f4deb/JK330/Document Technique JK330.odt

TRANSCEIVER

AM – FM – SSB – CW

3 Mhz – 30 Mhz

JK330

Jérôme Jézéquel 2013

Présentation Générale

# SYSTEME TECHNIQUE

## Mise en situation

De nos jours, il existe un nombre de moyens de communication immense. La radio-communication est un système de communication très performant, même avec de petits moyen. En effet, elle permet de contacter l'autre bout de la terre facilement si les conditions atmosphériques le permettent. Elle permet de communiquer à très longue distance à de nombreux radioamateurs de par la grande plage de fréquence et des différents systèmes de modulations utilisés.

OPERATEUR 1

TERRE

OPERATEUR 2

Il s'agit d'un récepteur Superhétérodyne de première conception. Celui-ci possédera de faible caractéristiques, mais il sera conçu de manière modulaire afin de pouvoir en améliorer les différentes caractéristiques. Il devra pouvoir couvrir une plage de fréquence variant de 3 Mhz à 30 Mhz et devra aussi pouvoir démoduler les modes AM FM BLU et CW.

## Présentation du système technique

### Choix d'un récepteur superhétérodyne

Le schéma synoptique d'un récepteur traditionnel avec un seul changement de fréquence est représenté ci-dessous.

BF

Fin

Fol

Ce schéma est simplifié, mais il permettra de démontrer les limitations d'une telle structure.

On cherche à recevoir une fréquence Fin. Après amplification et filtrage, ce signal est transmit au mélangeur qui reçoit aussi le signal provenant de l'oscillateur local Fol, Si on est en présence d'un mélangeur parfait, dans le sens radiocommunication, celui-ci délivre deux produits |Fol+Fin| et |Fol-Fin|. La génération de ces deux composants est due à des éléments fortement non linéaires : diodes ou transistors. Un mélangeur parfait serai un sous ensemble parfait d'ordre 2. En pratique, la non linéarité d'ordre 2 est prépondérante mais les non linéarités d'ordre 3,4,5, etc sont aussi présentent dans des proportions plus ou moins prononcées selon le type du mélangeur. Ceci signifie donc que l'on récupère en sortie plusieurs raies ou fréquences |mFol +- nFin| avec m et n entiers. Si m=1 et n=1, il s'agit du cas parfait mais toutes les combinaisons sont possibles.

Maintenant, traitons le choix de la fréquence intermédiaire FI, L'intérêt de cette fréquence est de faciliter le traitement de Fin.

Pour ce faire une idée, imaginons que Fin=10 Mhz et Fol=11 Mhz, il en résulte une fréquence FI=1Mhz et une deuxième FI=21Mhz qui est à éliminer. Celle-ci est éloignée de FI=20 Mhz et donc plus facile à supprimer. Notons que les produits d'intermodulations sont respectivement 12 Mhz, 31 Mhz et 32 Mhz tout aussi facile à supprimer.

Première constatation et conclusion, plus FI est faible et plus il est facile de l'amplifier et de le filtrer.

Maintenant, Fin = 12 Mhz et Fol = 11Mhz. Il en résulte une FI à 1 Mhz et une à 23 Mhz. Donc lorsque l’oscillateur locale est calé sur une fréquence, il reçoit deux fréquences simultanément. La fréquence à 23 Mhz est dite fréquence image. Elle est espacée de la fréquence à recevoir de 2xFol. Il faudra donc prendre une FI très grande, ce qui est contraire à la première conclusion.

Pour cette valeur, il n'y a pas de solution miracle, tout dépend de l’application. Le plus souvent, on rencontre les fréquences suivantes : 455Khz, 10,7Mhz, 21,4Mhz, 45Mhz, 70Mhz, 38,9Mhz en TV et 480Mhz en TVSat,

Reprenons le premier exemple, et supposons que l’on souhaite couvrir la plage de fréquence allant de 11Mhz à 12Mhz et que les Fi se situe entre 12 et 13 Mhz. Le filtre d'entrée doit éliminer les fréquences images. Il est clair que plus la FI est élevée et plus le filtre d'entrée est aisé à faire. De plus, plus la FI est basse et plus le coefficient de surtension du filtre devra être important et donc le filtre sera plus difficile à concevoir. Donc si on veut couvrir une large bande, il faudra que le filtre d'entrée soit asservit à l'oscillateur local ceci afin d'éliminer la fréquence image.

Une des premières possibilités serai de tronçonner la bande des fréquence à recevoir en plusieurs sous bandes; mais ceci nous contraindrai à faire autant d’oscillateur local que de sous bande.

Finalement une FI haute apporte une solution assez simple.

On en a conclut que le schéma synoptique précédant ne convient pas pour l'application prévu dans ce récepteur. La principale cause étant la difficulté de réaliser l'oscillateur local.

Si on prend le problème à l'envers, on s’aperçoit que l'on sait faire des oscillateurs allant de F à 2F, soit une octave. On sait aussi que la plage de couverture de l'oscillateur local est identique à celle de la plage de couverture du signal d'entré.

FI = Fol min – Fin min = Fol max -Fin max

FI < Fin min ou FI> Fin max

Donc pour couvrir la plage de 3Mhz à 30Mhz, il faut que Fol min = 45 Mhz+3 Mhz soit 48 Mhz et FI > 45 Mhz

Donc Fol min = 48 Mhz, Fol max = 75 Mhz pour FI = 45 Mhz. De plus Fimage = 90 Mhz,

Comme Fimage >> FI, celle ci sera plus facile à supprimer et donc le filtrage sera plus facile,

On effectuera un deuxième changement de fréquence à 9Mhz.

## Analyse Fonctionnelle du système

### Fonction d'usage

La fonction du système est de permettre l'écoute et la transmission de signaux entre radioamateurs entre 3 Mhz et 30 Mhz parmi les modes de transmissions tel que FM AM SSB et CW,

### Schéma fonctionnel de niveau 1 :

Opérateur

Antenne

Traitement

### Schéma fonctionnel de niveau 2 :

Traitement

Ondes accoustiques / Signal éléctrique

Ondes éléctromagnetique

ANALOGIQUE

Prise en compte des paramètres

NUMERIQUE

Réglages des paramètres en façade

Visualisation de la fréquence et des différents paramètres

JK330

## Analyse fonctionnelle :

### Présentation de la façade

C'est à partir de la façade que tous les réglages seront effectués. Les fonctions suivantes seront accessibles directement en façade.

Afficheur Monochrome LCD 240*64

Voyants :

- A : TX/RX
- B : PLL
- C : Alim ext
- D : Alim interne
- E : 12V
- F : 12 VTX
- G : 12 VRX
- H : 8V
- I : 5VA
- J : 5VD
- K : 3,3V

Fonctions :

- 1 : On/Off
- 2 : Volume
- 3 : AGC
- 4 : Band select 3,5/7/10/14/18/21/24/28
- 5 : VFO
- 6 : AF Gain
- 7 : RF Gain
- 8 : VFO CLAR
- 9 : Mod select LSB/USB/CW/FM
- 10 : Touche Fonction F1,, F7
- 11 : Clavier Numerique

Connexions Face Avant

- DIN 5 Broches
- Phone jack 6,5 mm
- Key Jack 3,5 mm
- DATA DB9
- RJ12 DEBUG

### Présentation de la face arrière

Les connexions suivantes seront disponibles en face arrière.

- 1 : Fiche secteur 220V
- 2 : Entrée 12V externe
- 3 : Antenne HF
- 4 : Antenne 50 Mhz
- 5 : Antenne VHF
- 6 : Antenen UHF

## Schéma fonctionnel RADIO du 1 er degrés

Ampli HF Sélection Filtre Passe bas Préampli HF HF Sélection antenne Sélection Filtre Passe Bande

Antenne

HF/50/VHF/UHF

Oscillateur 48Mhz-75Mhz 1er Mixer

Commutation HF RX / TX

Commutation HF RX / TX

Commutation HF RX / TX Ampli 45Mhz Ampli 45 Mhz Filtre à Quartz 45 Mhz 12,5Khz

Commutation HF RX / TX 2ème Mixer Commutation HF RX / TX

Oscillateur 54Mhz

Filtre à Quartz 9 Mhz 2,7Khz Ampli 9Mhz Commutation HF RX / TX

Ampli 9 Mhz Commutation HF RX / TX

Filtre BF

Ampli micro

Ampli BF

# MODULE JK330-1-BF

## Présentation

## Schéma Fonctionnel

## Schéma Structurel

## Typon

## Nomenclature

## Test et mise au point

# Module JK330-2-9Mhz

## Présentation

## Schéma Fonctionnel

## Schéma Structurel

## Typon

## Nomenclature

## Test et mise au point

# Module JK330-3-45Mhz

## Présentation

## Schéma Fonctionnel

## Schéma Structurel

## Typon

## Nomenclature

## Test et mise au point

# Module JK330-4-HF

## Présentation

## Schéma Fonctionnel

## Schéma Structurel

## Typon

## Nomenclature

## Test et mise au point

# Module JK330-5-OL9

## Présentation

## Schéma Fonctionnel

## Schéma Structurel

## Typon

## Nomenclature

## Test et mise au point

# Module JK330-6-OL54

## Présentation

## Schéma Fonctionnel

## Schéma Structurel

## Typon

## Nomenclature

## Test et mise au point

# Module JK330-7-SYNTHE

## Présentation

## Schéma Fonctionnel

## Schéma Structurel

## Typon

## Nomenclature

## Test et mise au point

# Module JK330-8-CPU

## Présentation

Le transceiver sera piloté par la carte MCU à base du PIC32MX795F512H.

Ce micro-contrôleur possède toutes les fonctions nécessaires ainsi que des fonctions qui pourront être développées par la suite.

Cette carte sera donc composée des fonctions suivantes :

- ICD pour la programmation et le developpement.
- Bouton RST pour effectuer un Reset manuel de la carte
- Connecteur KK-5 pour l'entrée des alimentations : GND/3,3V/5VA/5VD/12V
- Connecteur KK-4 pour la liaison I2C
- 2 Connecteurs KK-4 pour 2 liaisons série (une pour le débug et une pour communiquer avec l'exterieur.
- 5 Connecteurs KK-3 pour des I/O
- 3 Connecteurs HE10-10 permettant de commander chacun un clavier de 16 touches ainsi que 2 leds.
- Connecteur HE10-20 permettant de piloter un LCD graphique 240*64 monochrome
- 14 Connecteurs KK-3, soit 14 convertisseurs ou I/O.

## Schéma Fonctionnel

## Schéma Structurel

## Typon

## Nomenclature

## Test et mise au point

Avant de mettre sous tension la carte, il faut au préalable vérifier la continuité et surtout l'absence de cour-circuit entre les différentes alimentations.

TEST RS232

Pour tester la RS232-2 et RS232-3, il faut charger le projet

« TEST ELECTRONICAL_MAIN_BOARD_32.mcp » avec le fichier « testUartPic32.c »

compiler :

#define UARTTEST UART2 pour tester la RS232-2

#define UARTTEST UART3 pour tester la RS232-3

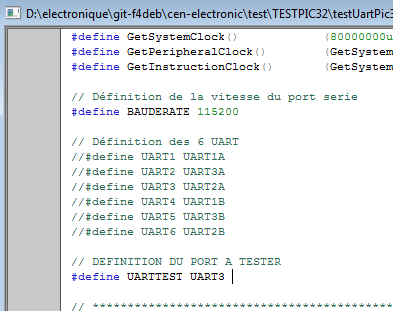
[picture p1: figure]

à l'aide de Termite, vérifier l'émission puis saisir « y » pour tester la réception du Pic32MX795F512H.

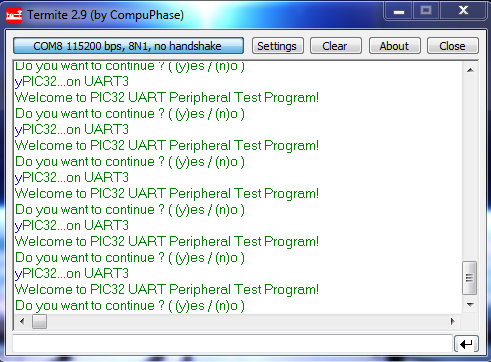
[picture p2: figure]

# Module JK330-9-POWER

## Présentation

Afin de disposer des différentes tensions d'alimentations nécessaires au fonctionnement des différentes cartes, la carte POWER fournira six différentes tensions. La tension + Batt qui est la tension fournit par l'alimentation interne 220V/13,8V. Cette partie n'a comme limite de courant que sa source. Elle est de 10A max pour l'alimentation 220V,

La tension 12V est régulée et fonctionne avec une tension d'alimentation pouvant varier de 4,75V à 25V. Son courant MAX est de 3A,

La tension 5V est régulée et fonctionne avec une tension d'alimentation pouvant varier de 4,75V à 25V. Son courant MAX est de 3A,

Les tensions +5VA et -5VA sont régulées à partir de la tension régulée de 5V, le courant est de +-300mA,

La tension 3,3V est régulée à partir de la tension +5V, le courant Max est de 800mA,

Le fonctionnement de chaque tension est visualisé avec une led verte par tension,

## Schéma Fonctionnel

+13,8V /10A +12V/3A +5V/3A +5VA/300mA -5VA/300mA +3,3V/800mA

Régulation en tension

Entrée 220V

X10 Connecteurs

6 leds

## Schéma Structurel

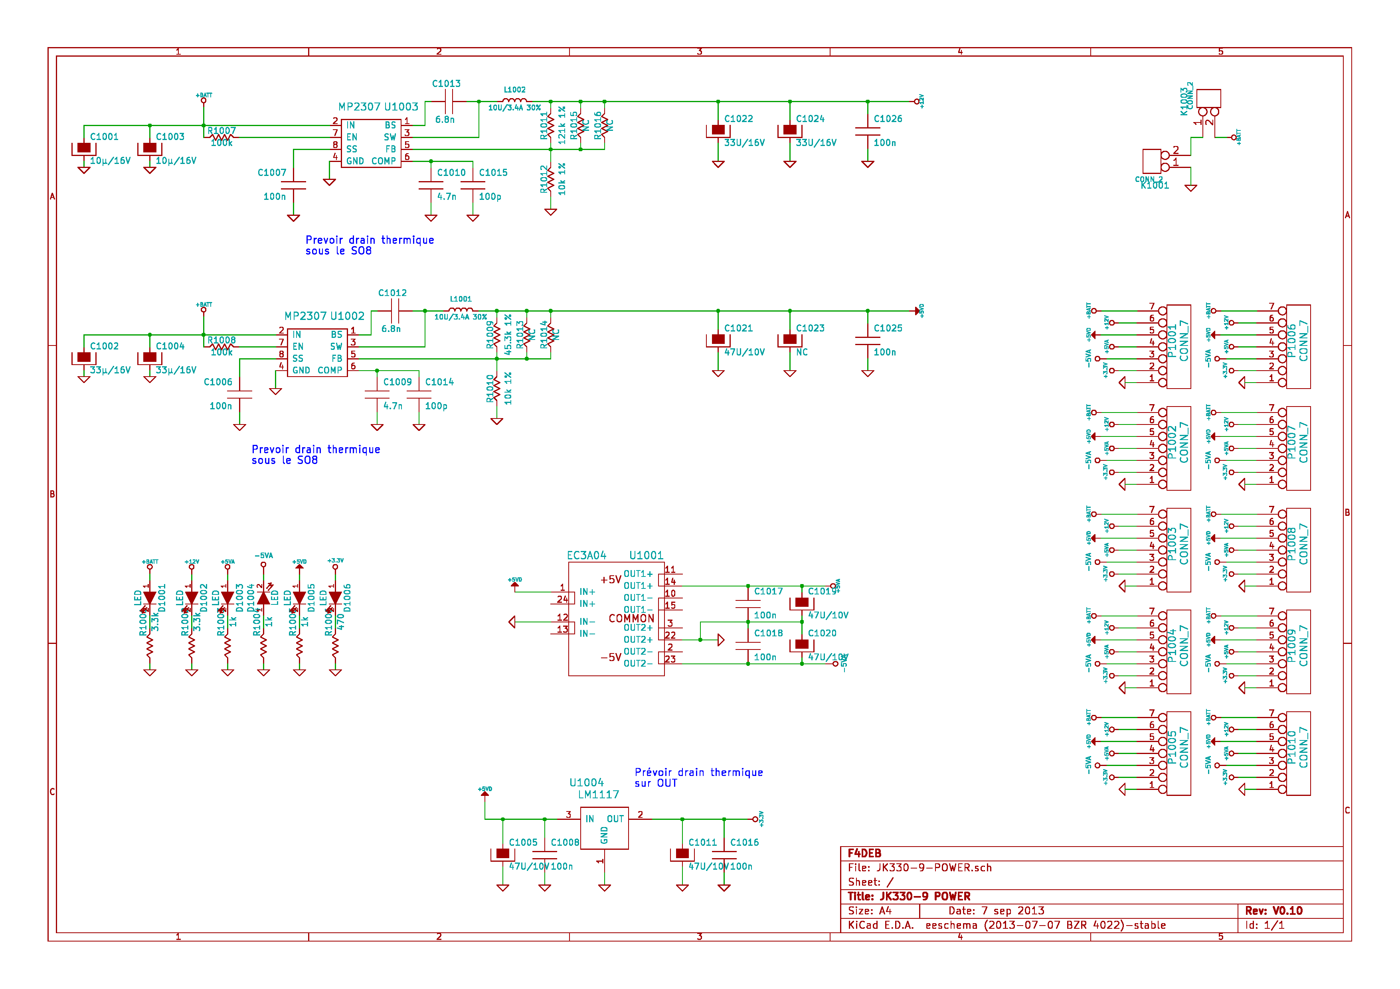
[picture p3: figure]

## Typon

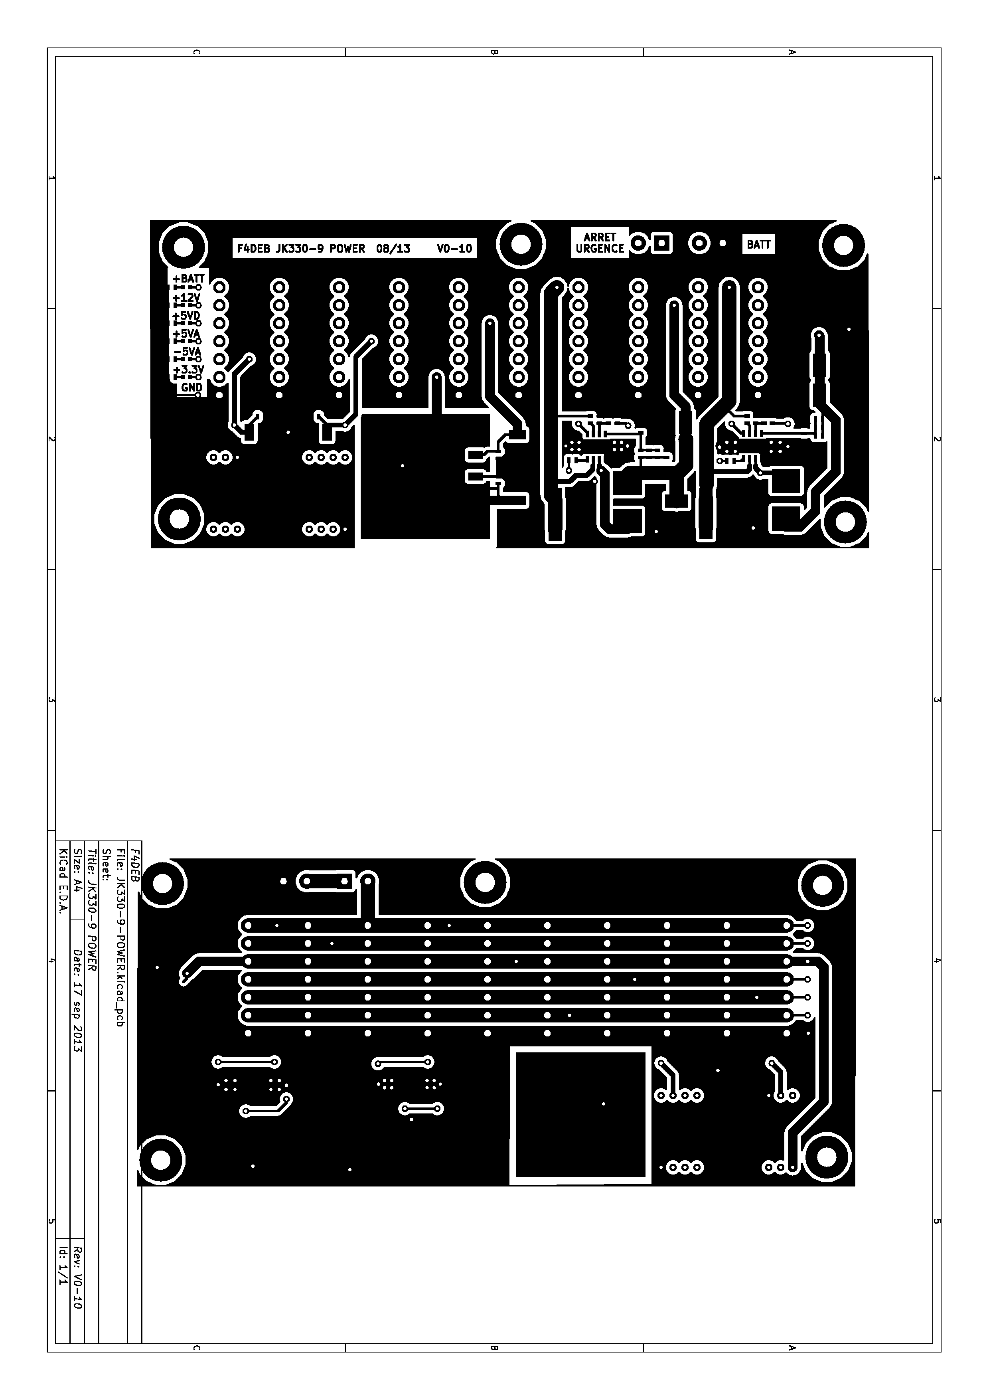
[picture p4: figure]

## Implantation

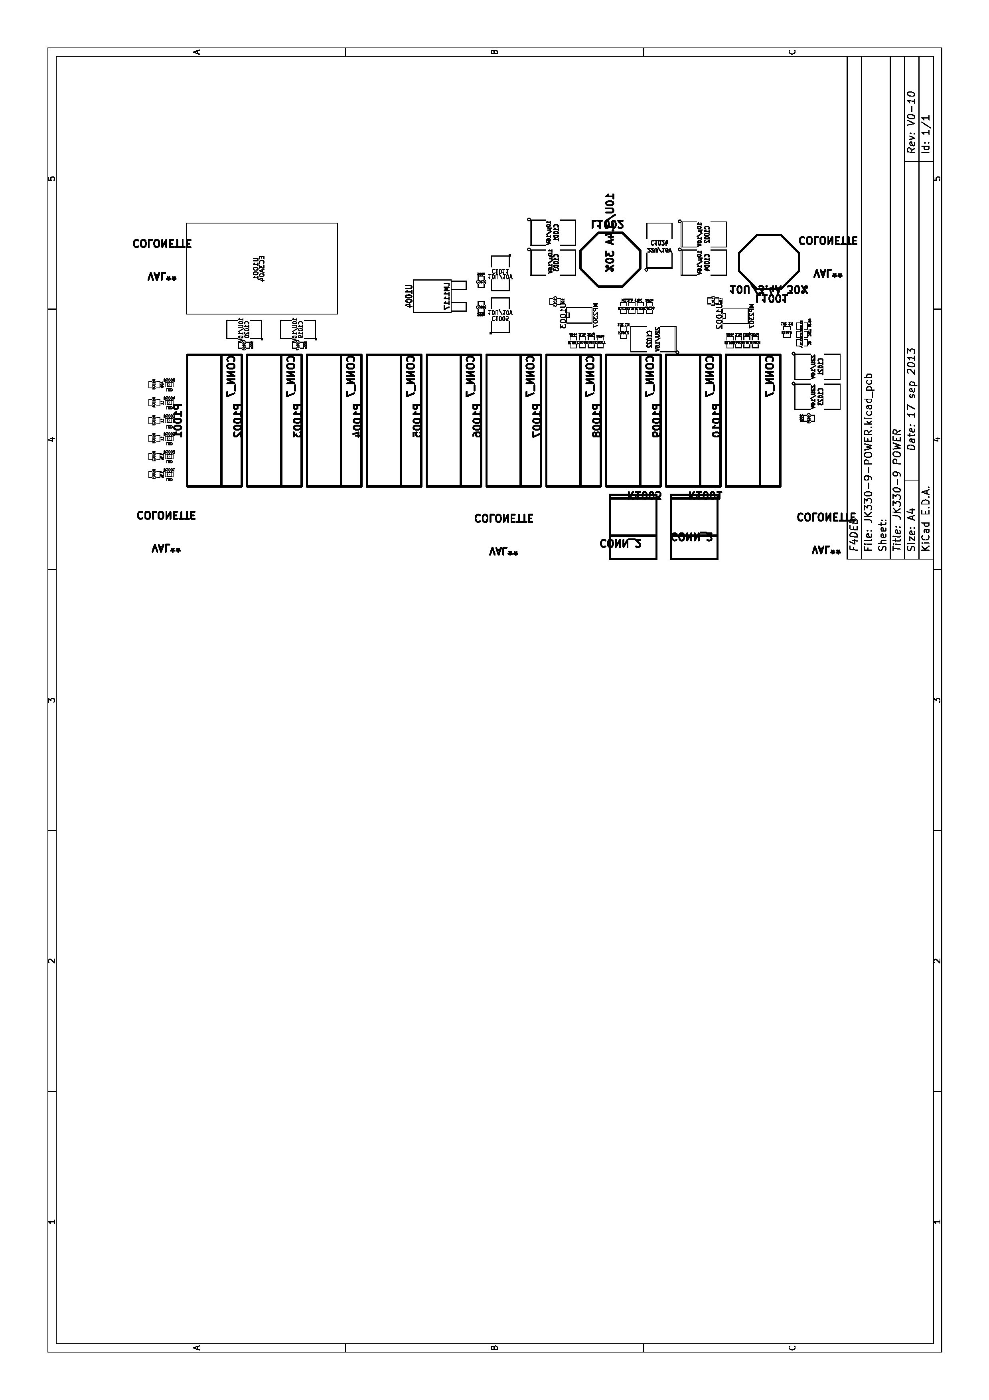
[picture p5: figure]

## Nomenclature

eeschema (2013-07-07 BZR 4022)-stable >> Creation date: 17/09/2013 22:07:12

#Cmp ( ordre = RÃ©fÃ©rence )

| C1001 10Âµ/16V ~ ; ~ ; ~

| C1002 33Âµ/16V ~ ; ~ ; ~

| C1003 10Âµ/16V ~ ; ~ ; ~

| C1004 33Âµ/16V ~ ; ~ ; ~

| C1005 47U/10V ~ ; ~ ; ~

| C1006 100n CMS 0603

| C1007 100n CMS 0603

| C1008 100n CMS 0603

| C1009 4.7n CMS 0603

| C1010 4.7n CMS 0603

| C1011 47U/10V ~ ; ~ ; ~

| C1012 6.8n CMS 0603

| C1013 6.8n CMS 0603

| C1014 100p CMS 0603

| C1015 100p CMS 0603

| C1016 100n CMS 0603

| C1017 100n CMS 0603

| C1018 100n CMS 0603

| C1019 47U/10V ~ ; ~ ; ~

| C1020 47U/10V ~ ; ~ ; ~

| C1021 47U/10V ~ ; ~ ; ~

| C1022 33U/16V ~ ; ~ ; ~

| C1023 NC ~ ; ~ ; ~

| C1024 33U/16V ~ ; ~ ; ~

| C1025 100n CMS 0603

| C1026 100n CMS 0603

| D1001 LED LED CMS 0603

| D1002 LED LED CMS 0603

| D1003 LED LED CMS 0603

| D1004 LED LED CMS 0603

| D1005 LED LED CMS 0603

| D1006 LED LED CMS 0603

| K1001 CONN_2 Phoenix Contact 5,08mm

| K1003 CONN_2 Phoenix Contact 5,08mm

| L1001 10U/3.4A 30%CMS

| L1002 10U/3.4A 30%CMS

| P1001 CONN_7 Phoenix Contact 3,5mm

| P1002 CONN_7 Phoenix Contact 3,5mm

| P1003 CONN_7 Phoenix Contact 3,5mm

| P1004 CONN_7 Phoenix Contact 3,5mm

| P1005 CONN_7 Phoenix Contact 3,5mm

| P1006 CONN_7 Phoenix Contact 3,5mm

| P1007 CONN_7 Phoenix Contact 3,5mm

| P1008 CONN_7 Phoenix Contact 3,5mm

| P1009 CONN_7 Phoenix Contact 3,5mm

| P1010 CONN_7 Phoenix Contact 3,5mm

| R1001 3.3k RES 5% 0603

| R1002 3.3k RES 5% 0603

| R1003 1k RES 5% 0603

| R1004 1k RES 5% 0603

| R1005 1k RES 5% 0603

| R1006 470 RES 5% 0603

| R1007 100k RES 5% 0603

| R1008 100k RES 5% 0603

| R1009 45.3k 1% ~ ; ~ ; ~

| R1010 10k 1% RES 1% 0603

| R1011 121k 1% ~ ; ~ ; ~

| R1012 10k 1% RES 1% 0603

| R1013 NC ~ ; ~ ; ~

| R1014 NC ~ ; ~ ; ~

| R1015 NC ~ ; ~ ; ~

| R1016 NC ~ ; ~ ; ~

| U1001 EC3A04 ; ;

| U1002 MP2307 ; ;

| U1003 MP2307 ; ;

| U1004 LM1117 ; ;

#End Cmp

#End List

## Test et mise au point

- Effectuer un test de continuité sur chaque sortie
- Effectuer un test de continuité sur l'entrée alim,
- Mettre sous tension
- Vérifier l'allumage des 6 leds de visualisation des tensions : D1001-D1006
- Vérifier la tension sur chaque sortie,
- TEST EN CHARGE DES TENSIONS
- Sur la sortie + 12V, brancher une lampe de voiture de 21W+5W+5W
- Sur la sortie +5V, brancher une lampe de voiture de
- Sur la sortie +5VA
- Sur la sortie -5VA
- Sur la sortie +3,3V

## PHOTOS
