f4deb/JK330/Ariane/ariane.png

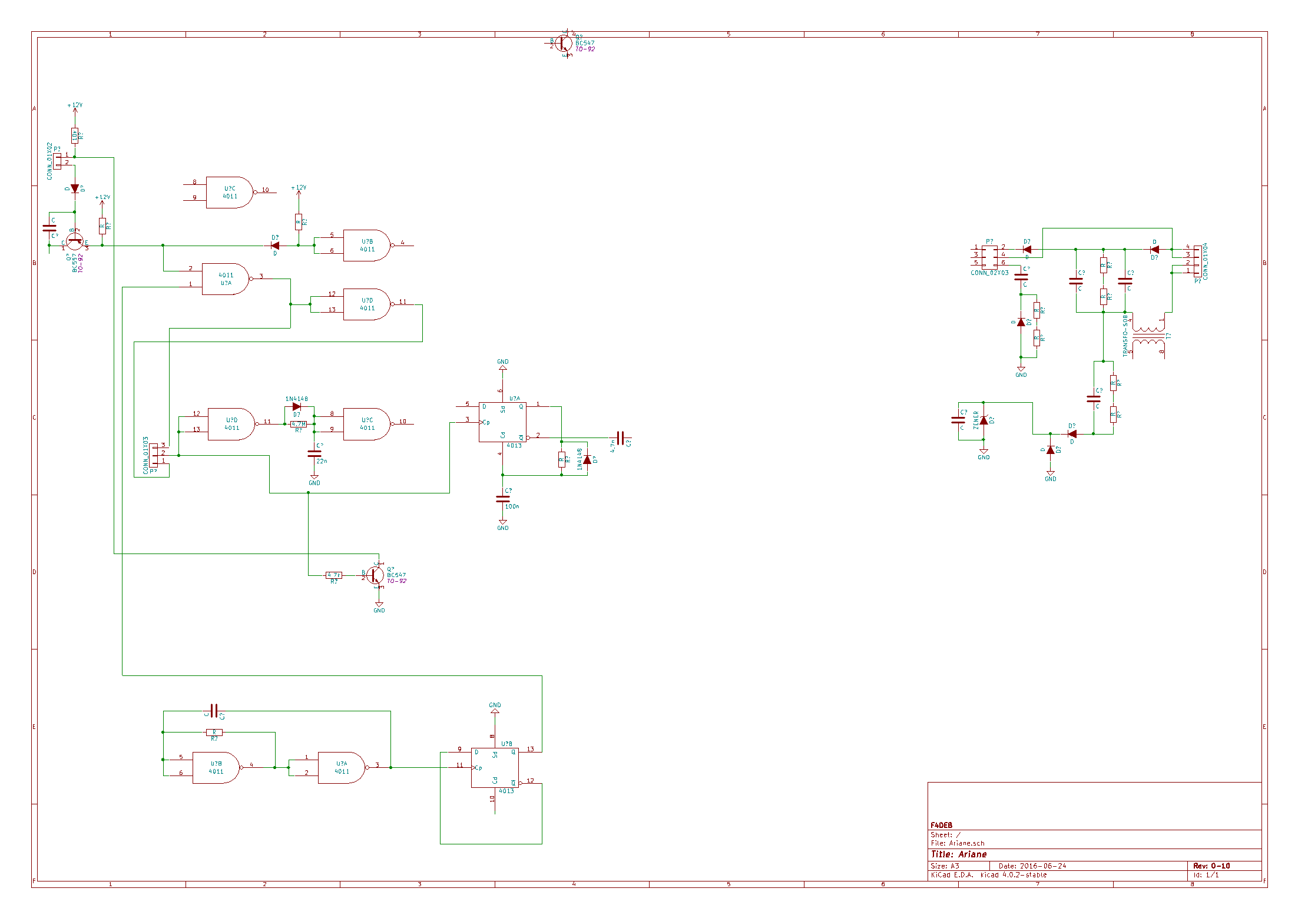
Ariane/ariane.png
