f4deb/JK330/Power_expander/V1-00/power expandleur.kicad_pcb

## KiCad design Power_expander/V1-00/power expandleur.kicad_pcb (2017-03-22, an earlier design)

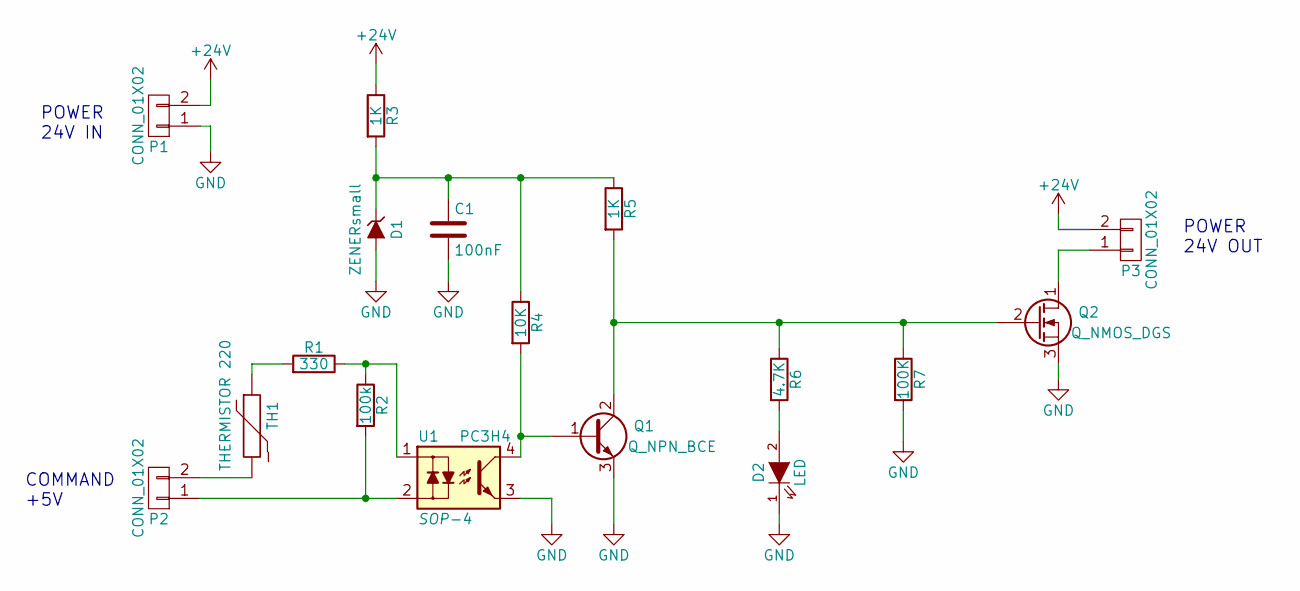
[picture p7: schematic power expandleur.sch, Power Expander]

Parts:
C1: 100nF; C_0603
D1: ZENERsmall; SMA_Standard
D2: LED; LED_0805
P1, P2, P3: CONN_01X02; bornier2
Q1: Q_NPN_BCE; SOT-23
Q2: Q_NMOS_DGS; SOT-669_LFPAK
R1: 330; R_0603
R2: 100k; R_0603
R3, R5: 1K; R_0603
R4: 10K; R_0603
R6: 4.7K; R_0603
R7: 100K; R_0603
TH1: THERMISTOR 220; R_0603
U1: PC3H4; SOP-4

Connections:
+24V: P1.2, P3.2, R3.1
GND: C1.2, D1.2 (A), D2.1 (K), P1.1, Q1.3 (E), Q2.3 (S), R7.2, U1.3
unnamed: C1.1, D1.1 (K), R3.2, R4.1, R5.1
unnamed: D2.2 (A), R6.2
unnamed: P2.1, R2.2, U1.2
unnamed: P2.2, TH1.2
unnamed: P3.1, Q2.1 (D)
unnamed: Q1.1 (B), R4.2, U1.4
unnamed: Q1.2 (C), Q2.2 (G), R5.2, R6.1, R7.1
unnamed: R1.1, R2.1, U1.1
unnamed: R1.2, TH1.1

Notes on the sheet:
POWER 24V IN
POWER 24V OUT
COMMAND +5V

Board: 2 copper layers, 16 parts (0 on the bottom side), 11 nets, no tracks yet.
