f4deb/JK330/JK330-10-INTERFACE/IHM.kicad_pcb

## KiCad design JK330-10-INTERFACE/IHM.kicad_pcb (2014-02-02)

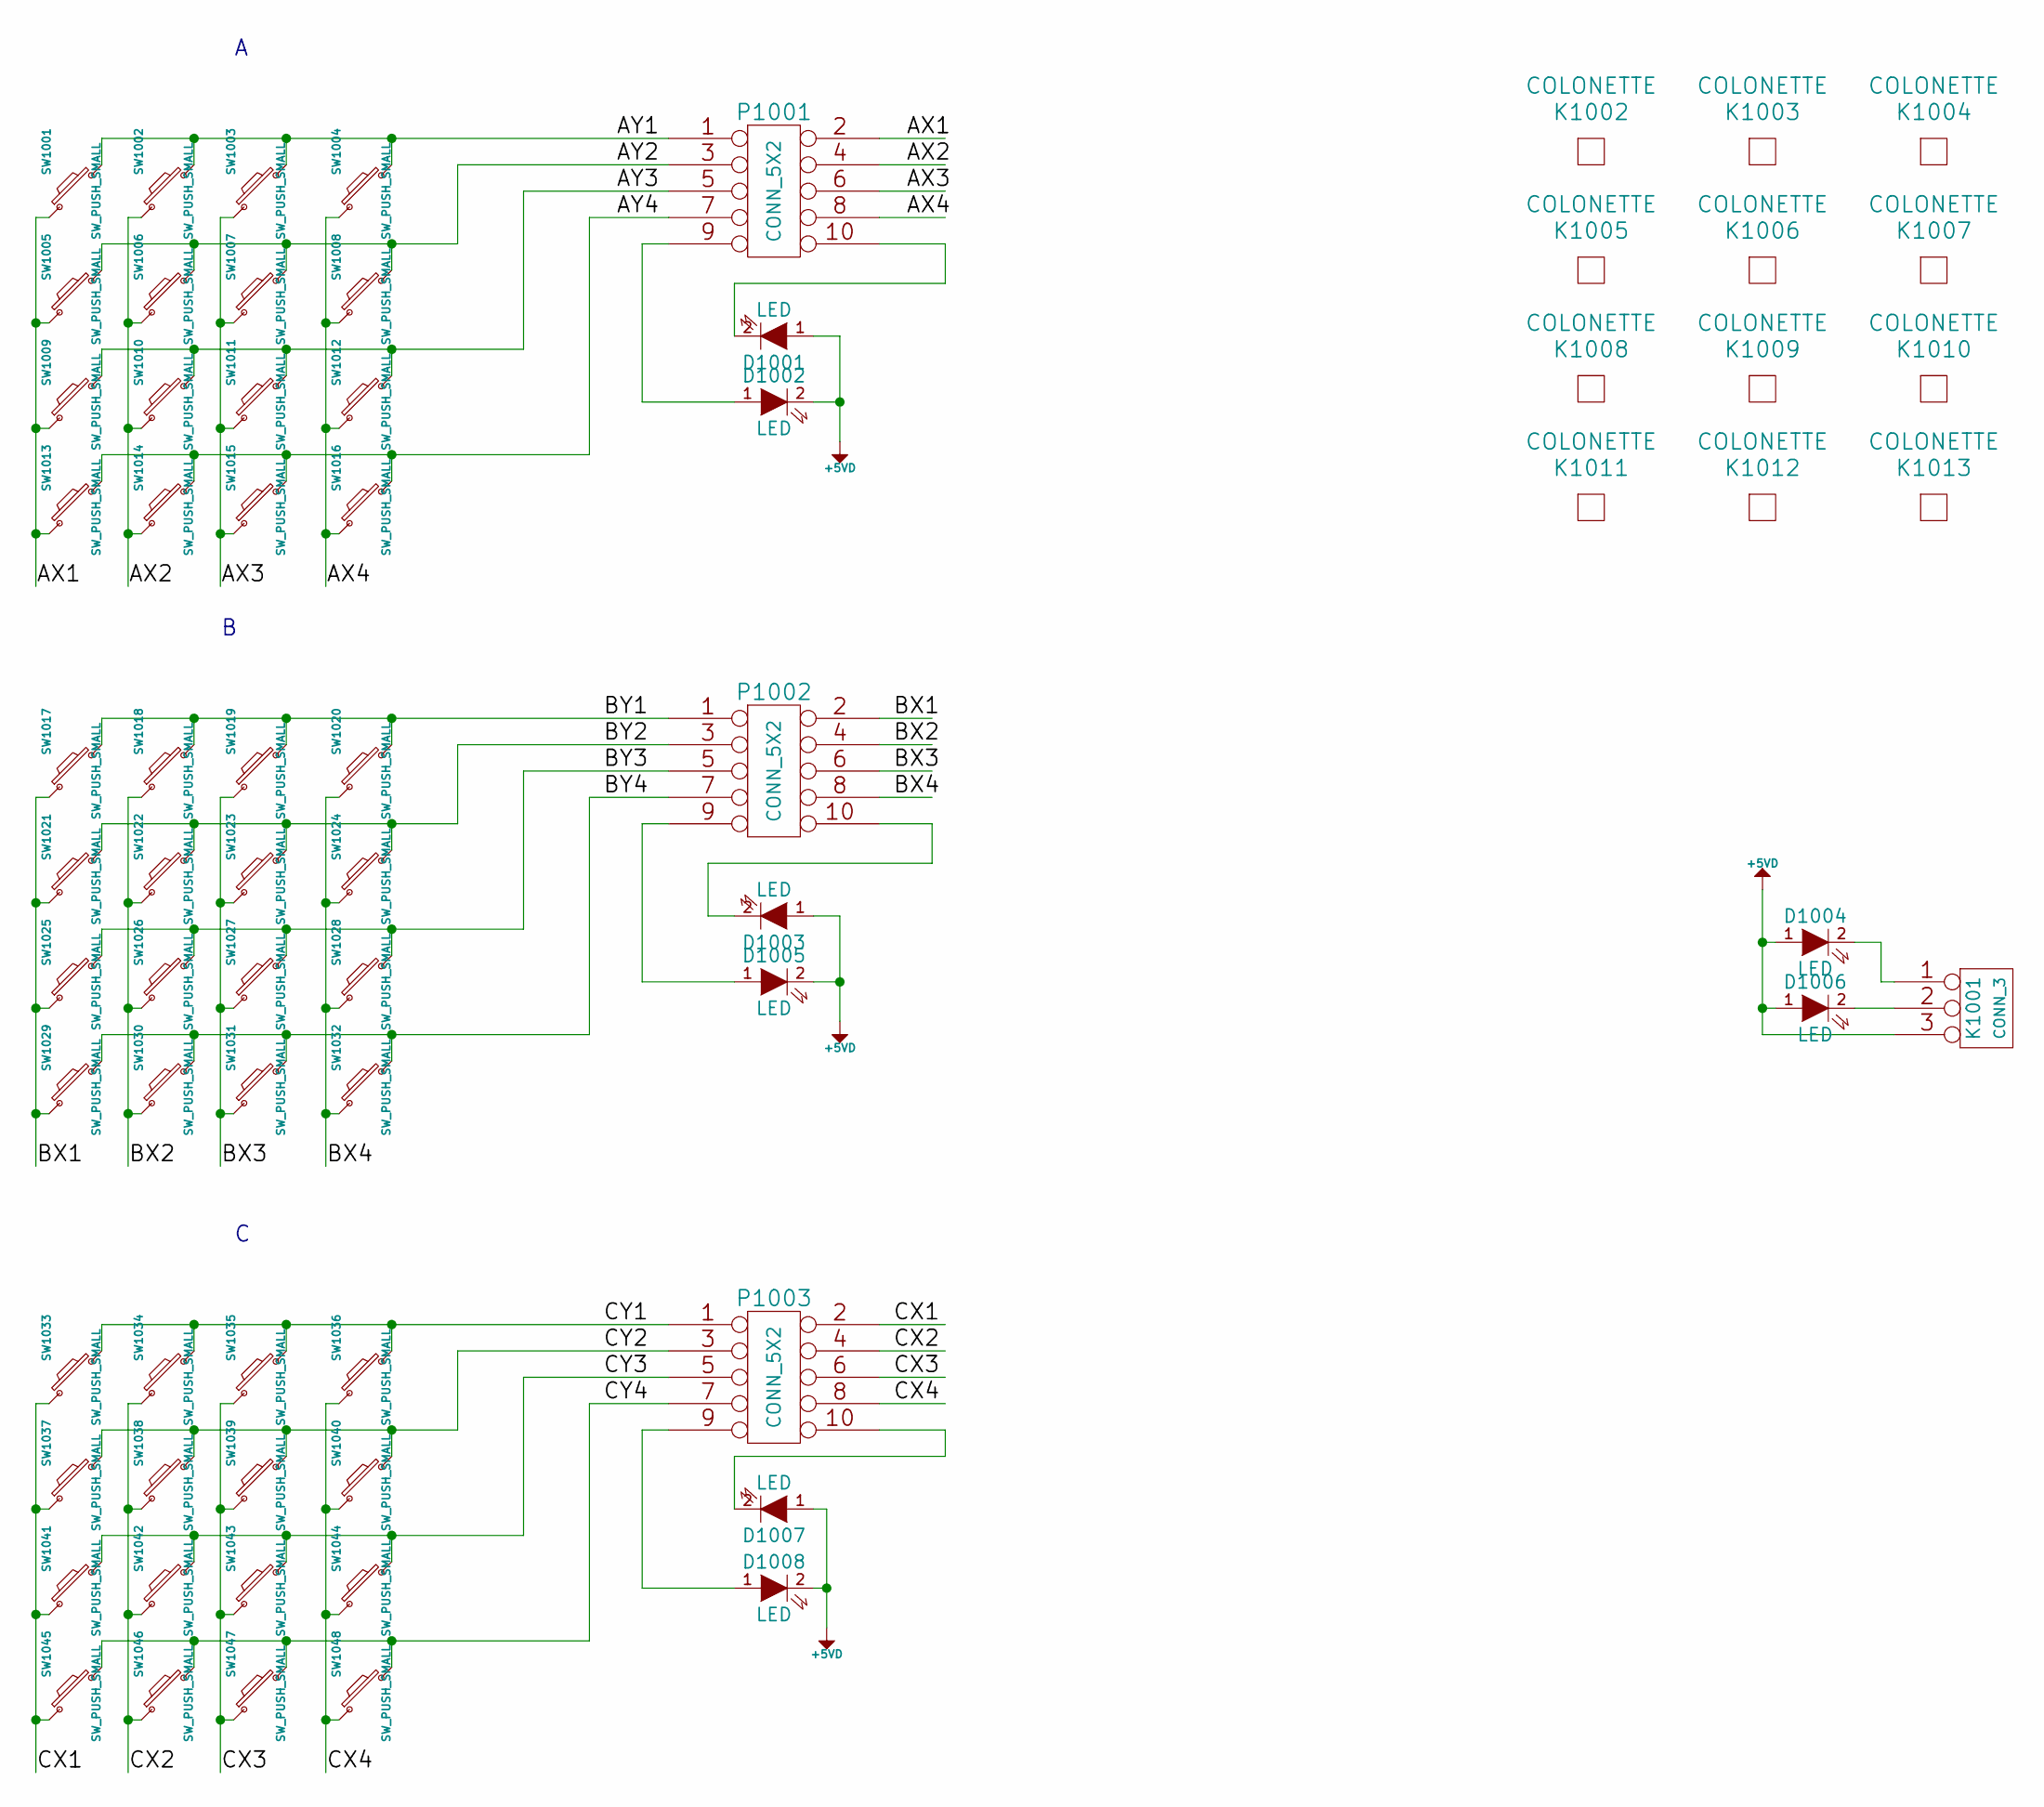
[picture p8: schematic IHM.sch]

Parts:
D1001, D1002, D1003, D1004, D1005, D1006, D1007, D1008: LED
K1001: CONN_3
K1002, K1003, K1004, K1005, K1006, K1007, K1008, K1009, K1010, K1011, K1012, K1013: COLONETTE
P1001, P1002, P1003: CONN_5X2
SW1001, SW1002, SW1003, SW1004, SW1005, SW1006, SW1007, SW1008, SW1009, SW1010, SW1011, SW1012, SW1013, SW1014, SW1015, SW1016, SW1017, SW1018, SW1019, SW1020, SW1021, SW1022, SW1023, SW1024, SW1025, SW1026, SW1027, SW1028, SW1029, SW1030, SW1031, SW1032, SW1033, SW1034, SW1035, SW1036, SW1037, SW1038, SW1039, SW1040, SW1041, SW1042, SW1043, SW1044, SW1045, SW1046, SW1047, SW1048: SW_PUSH_SMALL

Connections:
+5VD: D1001.1 (A), D1002.2 (K), D1003.1 (A), D1004.1 (A), D1005.2 (K), D1006.1 (A), D1007.1 (A), D1008.2 (K), K1001.3
/AX1: P1001.2, SW1001.1, SW1005.1, SW1009.1, SW1013.1
/AX2: P1001.4, SW1002.1, SW1006.1, SW1010.1, SW1014.1
/AX3: P1001.6, SW1003.1, SW1007.1, SW1011.1, SW1015.1
/AX4: P1001.8, SW1004.1, SW1008.1, SW1012.1, SW1016.1
/AY1: P1001.1, SW1001.2, SW1002.2, SW1003.2, SW1004.2
/AY2: P1001.3, SW1005.2, SW1006.2, SW1007.2, SW1008.2
/AY3: P1001.5, SW1009.2, SW1010.2, SW1011.2, SW1012.2
/AY4: P1001.7, SW1013.2, SW1014.2, SW1015.2, SW1016.2
/BX1: P1002.2, SW1017.1, SW1021.1, SW1025.1, SW1029.1
/BX2: P1002.4, SW1018.1, SW1022.1, SW1026.1, SW1030.1
/BX3: P1002.6, SW1019.1, SW1023.1, SW1027.1, SW1031.1
/BX4: P1002.8, SW1020.1, SW1024.1, SW1028.1, SW1032.1
/BY1: P1002.1, SW1017.2, SW1018.2, SW1019.2, SW1020.2
/BY2: P1002.3, SW1021.2, SW1022.2, SW1023.2, SW1024.2
/BY3: P1002.5, SW1025.2, SW1026.2, SW1027.2, SW1028.2
/BY4: P1002.7, SW1029.2, SW1030.2, SW1031.2, SW1032.2
/CX1: P1003.2, SW1033.1, SW1037.1, SW1041.1, SW1045.1
/CX2: P1003.4, SW1034.1, SW1038.1, SW1042.1, SW1046.1
/CX3: P1003.6, SW1035.1, SW1039.1, SW1043.1, SW1047.1
/CX4: P1003.8, SW1036.1, SW1040.1, SW1044.1, SW1048.1
/CY1: P1003.1, SW1033.2, SW1034.2, SW1035.2, SW1036.2
/CY2: P1003.3, SW1037.2, SW1038.2, SW1039.2, SW1040.2
/CY3: P1003.5, SW1041.2, SW1042.2, SW1043.2, SW1044.2
/CY4: P1003.7, SW1045.2, SW1046.2, SW1047.2, SW1048.2
unnamed: D1007.2 (K), P1003.10
unnamed: D1004.2 (K), K1001.1
unnamed: D1006.2 (K), K1001.2 (PM)
unnamed: D1005.1 (A), P1002.9
unnamed: D1001.2 (K), P1001.10
unnamed: D1002.1 (A), P1001.9
unnamed: D1003.2 (K), P1002.10
unnamed: D1008.1 (A), P1003.9

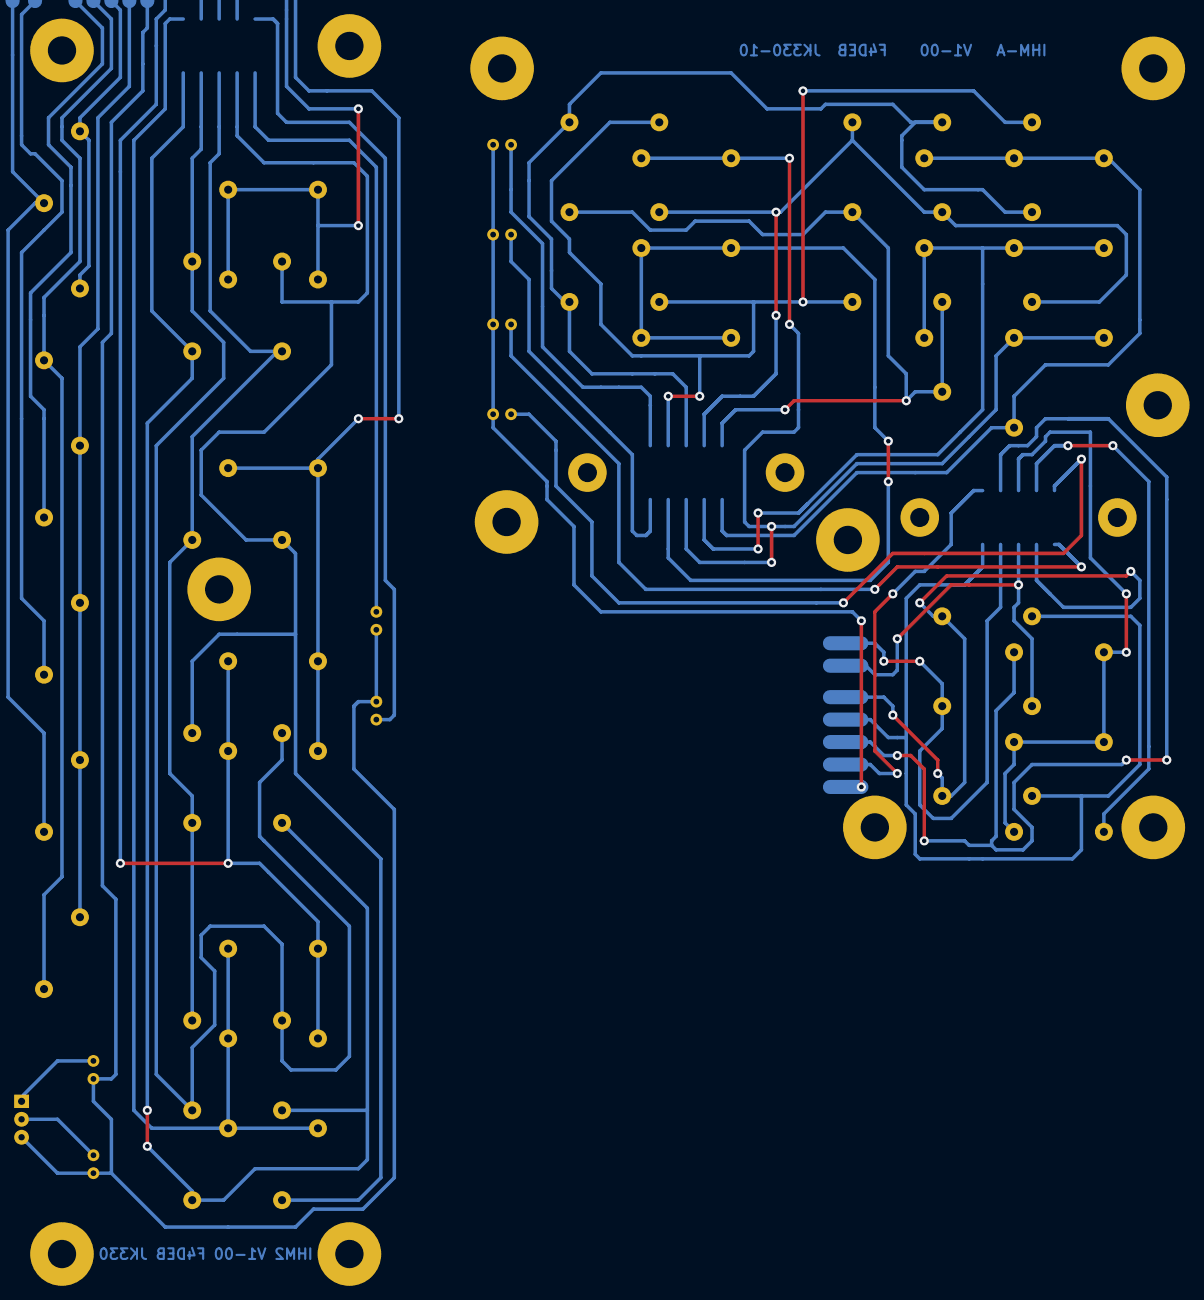
[picture p9: board IHM.kicad_pcb from above]

Board: 2 copper layers, 68 parts (0 on the bottom side), 33 nets.
