f4deb/JK330/JK330-5-OL9/OL9Mhz.kicad_pcb

## KiCad design JK330-5-OL9/OL9Mhz.kicad_pcb (2014-02-02)

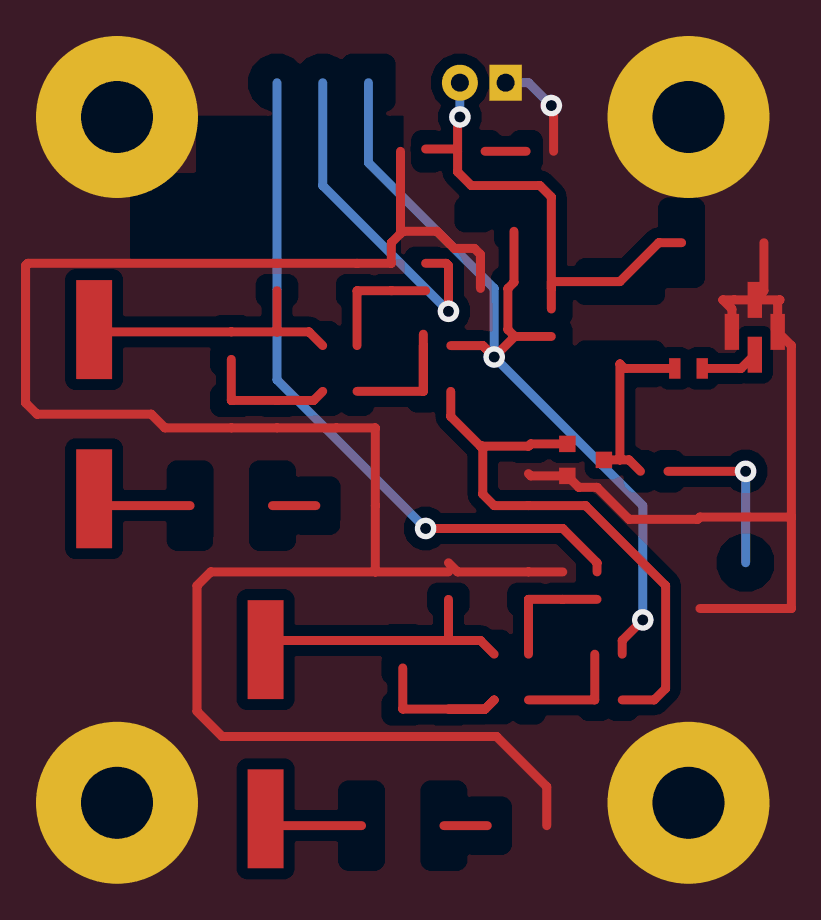
[picture p10: board OL9Mhz.kicad_pcb from above]

Board: 2 copper layers, 10 parts (0 on the bottom side), 3 nets.

Parts:
C15: 1n; SM0603_Capa
K2: CONN_2; KK-2-HOR
K3, K4, K5, K6: COLONETTE
P2: BNC; U.FL
Q1: BSN20; SOT23EBC
X1, X2: 9Mhz; Q_49U3HMS

Connections:
GND: K2.1, K3.1, K4.1, K5.1, K6.1, P2.2, Q1.1
unnamed: C15.2, P2.1
unnamed: C15.1, Q1.3
