f4deb/JK330/jk330-8-CPU/ELECTRONICAL_MAIN_BOARD_32.kicad_pcb

## KiCad design jk330-8-CPU/ELECTRONICAL_MAIN_BOARD_32.kicad_pcb (2014-02-02)

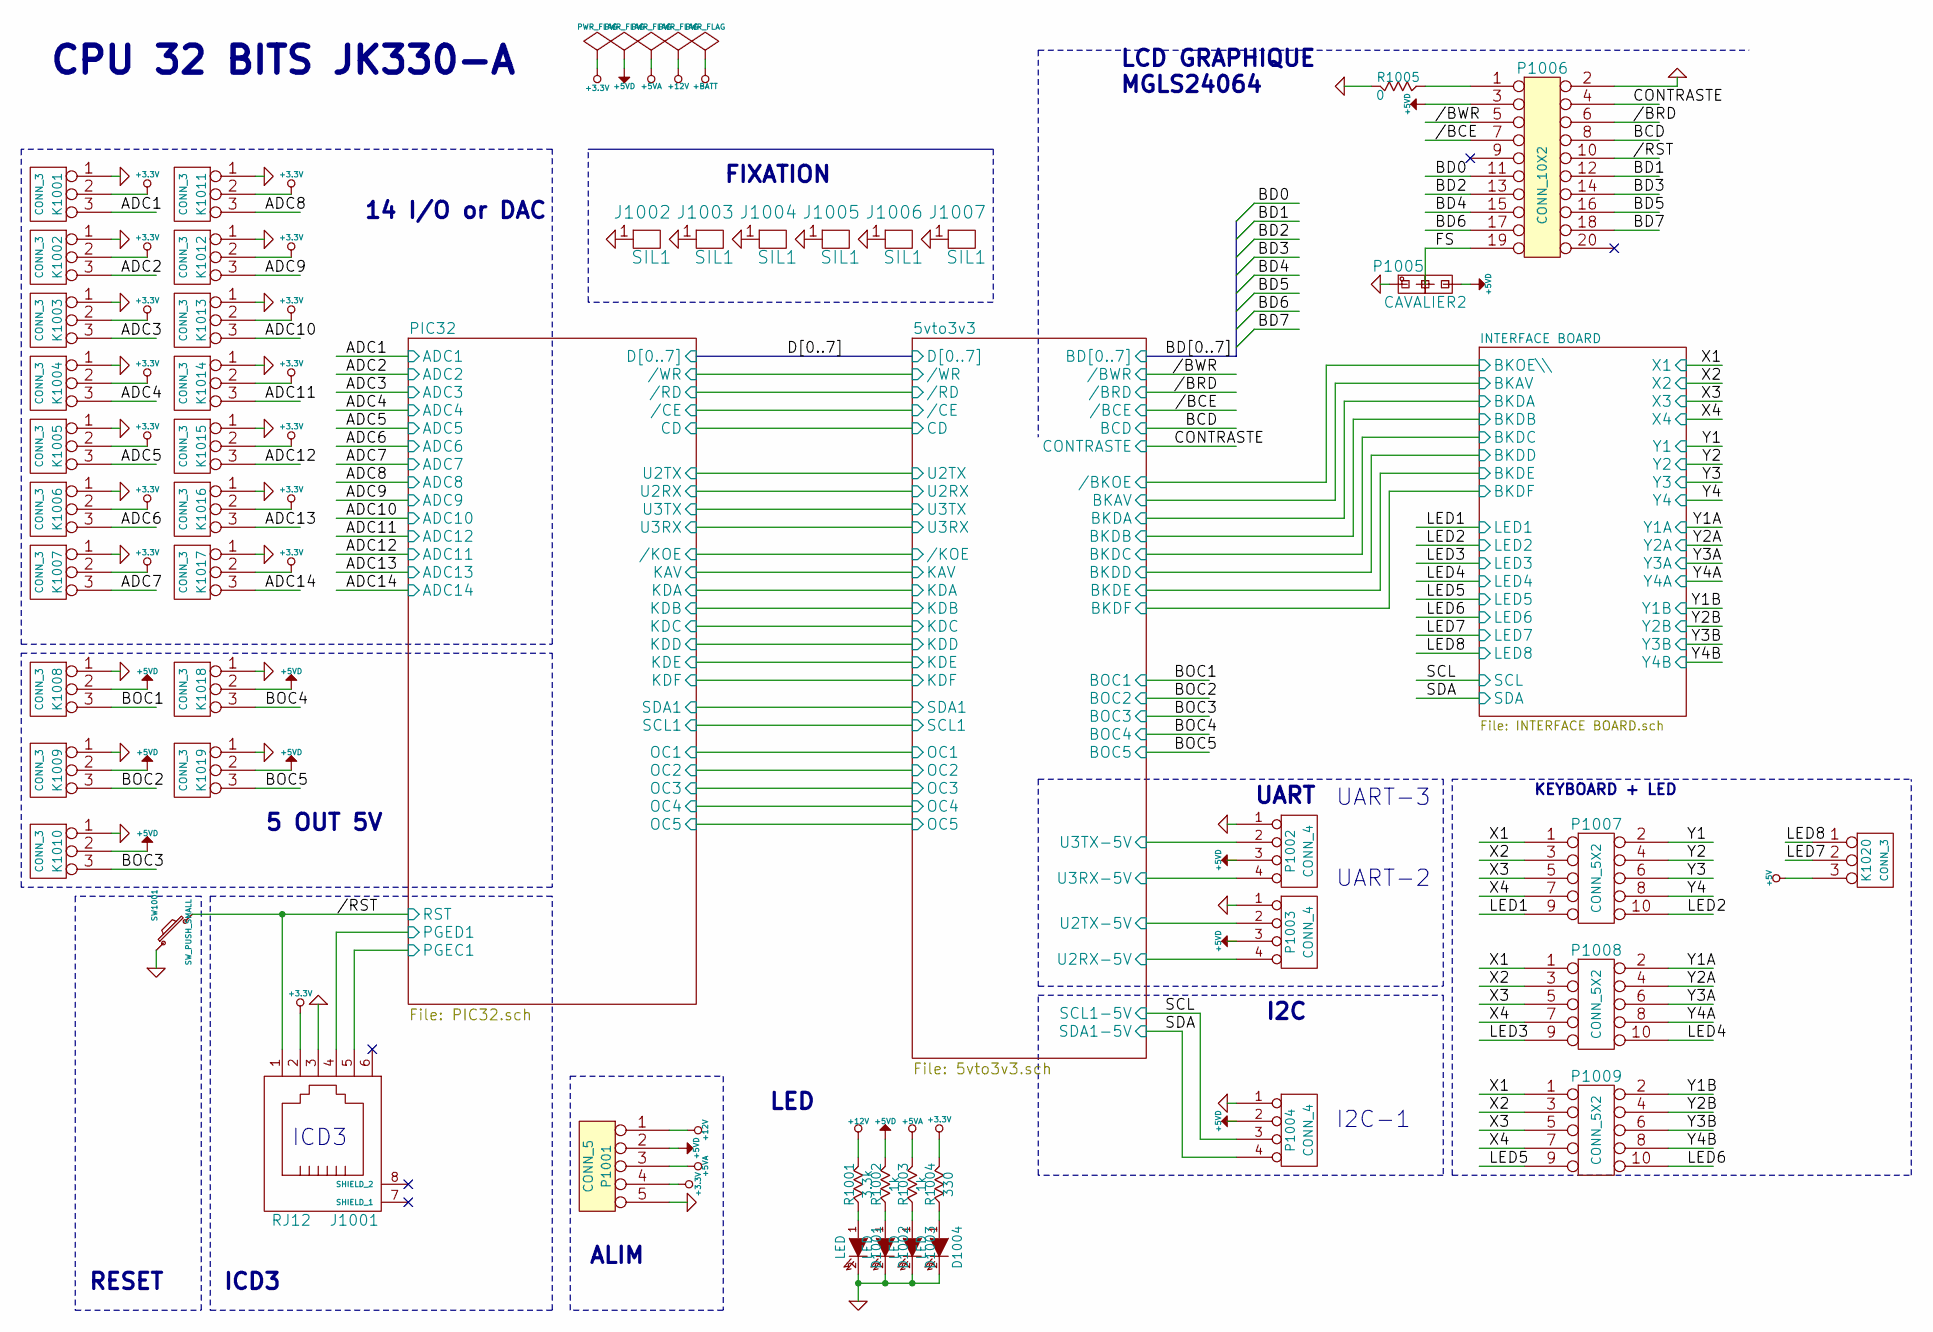
[picture p11: schematic ELECTRONICAL_MAIN_BOARD_32.sch, JK330-CPU]

Parts:
D1001, D1002, D1003, D1004: LED
J1001: RJ12
J1002, J1003, J1004, J1005, J1006, J1007: SIL1
K1001, K1002, K1003, K1004, K1005, K1006, K1007, K1008, K1009, K1010, K1011, K1012, K1013, K1014, K1015, K1016, K1017, K1018, K1019, K1020: CONN_3
P1001: CONN_5
P1002, P1003, P1004: CONN_4
P1005: CAVALIER2
P1006: CONN_10X2
P1007, P1008, P1009: CONN_5X2
R1001: 3.3k
R1002: 1k
R1003: 1k
R1004: 330
R1005: 0
SW1001: SW_PUSH_SMALL

Connections:
+3.3V: J1001.2, K1001.2 (PM), K1002.2 (PM), K1003.2 (PM), K1004.2 (PM), K1005.2 (PM), K1006.2 (PM), K1007.2 (PM), K1011.2 (PM), K1012.2 (PM), K1013.2 (PM), K1014.2 (PM), K1015.2 (PM), K1016.2 (PM), K1017.2 (PM), P1001.4, R1004.1; also elsewhere on the board
+5VA: P1001.3, R1003.1
+5VD: K1008.2 (PM), K1009.2 (PM), K1010.2 (PM), K1018.2 (PM), K1019.2 (PM), P1001.2, P1002.3, P1003.3, P1004.2, P1005.3, P1006.3, R1002.1; also elsewhere on the board
+12V: P1001.1, R1001.1
/5vto3v3//BCE: P1006.7; also elsewhere on the board
/5vto3v3//BRD: P1006.6; also elsewhere on the board
/5vto3v3//BWR: P1006.5; also elsewhere on the board
/5vto3v3/BCD: P1006.8; also elsewhere on the board
/5vto3v3/BOC1: K1008.3; also elsewhere on the board
/5vto3v3/BOC2: K1009.3; also elsewhere on the board
/5vto3v3/BOC3: K1010.3; also elsewhere on the board
/5vto3v3/BOC4: K1018.3; also elsewhere on the board
/5vto3v3/BOC5: K1019.3; also elsewhere on the board
/5vto3v3/CONTRASTE: P1006.4; also elsewhere on the board
/5vto3v3/U2RX-5V: P1003.4; also elsewhere on the board
/5vto3v3/U2TX-5V: P1003.2; also elsewhere on the board
/5vto3v3/U3RX-5V: P1002.4; also elsewhere on the board
/5vto3v3/U3TX-5V: P1002.2; also elsewhere on the board
/BD0: P1006.11; also elsewhere on the board
/BD1: P1006.12; also elsewhere on the board
/BD2: P1006.13; also elsewhere on the board
/BD3: P1006.14; also elsewhere on the board
/BD4: P1006.15; also elsewhere on the board
/BD5: P1006.16; also elsewhere on the board
/BD6: P1006.17; also elsewhere on the board
/BD7: P1006.18; also elsewhere on the board
/FS: P1005.2, P1006.19
/INTERFACE BOARD/LED1: P1007.9; also elsewhere on the board
/INTERFACE BOARD/LED2: P1007.10; also elsewhere on the board
/INTERFACE BOARD/LED3: P1008.9; also elsewhere on the board
/INTERFACE BOARD/LED4: P1008.10; also elsewhere on the board
/INTERFACE BOARD/LED5: P1009.9; also elsewhere on the board
/INTERFACE BOARD/LED6: P1009.10; also elsewhere on the board
/INTERFACE BOARD/LED7: K1020.2 (PM); also elsewhere on the board
/INTERFACE BOARD/LED8: K1020.1; also elsewhere on the board
/INTERFACE BOARD/SCL: P1004.3; also elsewhere on the board
/INTERFACE BOARD/SDA: P1004.4; also elsewhere on the board
/INTERFACE BOARD/X1: P1007.1, P1008.1, P1009.1; also elsewhere on the board
/INTERFACE BOARD/X2: P1007.3, P1008.3, P1009.3; also elsewhere on the board
/INTERFACE BOARD/X3: P1007.5, P1008.5, P1009.5; also elsewhere on the board
/INTERFACE BOARD/X4: P1007.7, P1008.7, P1009.7; also elsewhere on the board
/INTERFACE BOARD/Y1: P1007.2; also elsewhere on the board
/INTERFACE BOARD/Y1A: P1008.2; also elsewhere on the board
/INTERFACE BOARD/Y1B: P1009.2; also elsewhere on the board
/INTERFACE BOARD/Y2: P1007.4; also elsewhere on the board
/INTERFACE BOARD/Y2A: P1008.4; also elsewhere on the board
/INTERFACE BOARD/Y2B: P1009.4; also elsewhere on the board
/INTERFACE BOARD/Y3: P1007.6; also elsewhere on the board
/INTERFACE BOARD/Y3A: P1008.6; also elsewhere on the board
/INTERFACE BOARD/Y3B: P1009.6; also elsewhere on the board
/INTERFACE BOARD/Y4: P1007.8; also elsewhere on the board
/INTERFACE BOARD/Y4A: P1008.8; also elsewhere on the board
/INTERFACE BOARD/Y4B: P1009.8; also elsewhere on the board
/PIC32/ADC1: K1001.3; also elsewhere on the board
/PIC32/ADC2: K1002.3; also elsewhere on the board
/PIC32/ADC3: K1003.3; also elsewhere on the board
/PIC32/ADC4: K1004.3; also elsewhere on the board
/PIC32/ADC5: K1005.3; also elsewhere on the board
/PIC32/ADC6: K1006.3; also elsewhere on the board
/PIC32/ADC7: K1007.3; also elsewhere on the board
/PIC32/ADC8: K1011.3; also elsewhere on the board
/PIC32/ADC9: K1012.3; also elsewhere on the board
/PIC32/ADC10: K1013.3; also elsewhere on the board
/PIC32/ADC11: K1015.3; also elsewhere on the board
/PIC32/ADC12: K1014.3; also elsewhere on the board
/PIC32/ADC13: K1016.3; also elsewhere on the board
/PIC32/ADC14: K1017.3; also elsewhere on the board
/PIC32/PGEC1: J1001.5; also elsewhere on the board
/PIC32/PGED1: J1001.4; also elsewhere on the board
/PIC32/RST: J1001.1, P1006.10, SW1001.2; also elsewhere on the board
GND: D1001.2 (K), D1002.2 (K), D1003.2 (K), D1004.2 (K), J1001.3, J1001.7 (SHIELD_1), J1001.8 (SHIELD_2), J1002.1, J1003.1, J1004.1, J1005.1, J1006.1, J1007.1, K1001.1, K1002.1, K1003.1, K1004.1, K1005.1, K1006.1, K1007.1, K1008.1, K1009.1, K1010.1, K1011.1, K1012.1, K1013.1, K1014.1, K1015.1, K1016.1, K1017.1, K1018.1, K1019.1, P1001.5, P1002.1, P1003.1, P1004.1, P1005.1, P1006.2, R1005.1, SW1001.1; also elsewhere on the board
unnamed: D1003.1 (A), R1003.2
unnamed: P1006.1, R1005.2
unnamed: D1001.1 (A), R1001.2
unnamed: D1004.1 (A), R1004.2
unnamed: D1002.1 (A), R1002.2

Notes on the sheet:
ALIM
LED
CPU 32 BITS JK330-A
LCD GRAPHIQUE MGLS24064
ICD3
UART
I2C
I2C-1
UART-3
FIXATION
UART-2
RESET
KEYBOARD + LED
5 OUT 5V
14 I/O or DAC

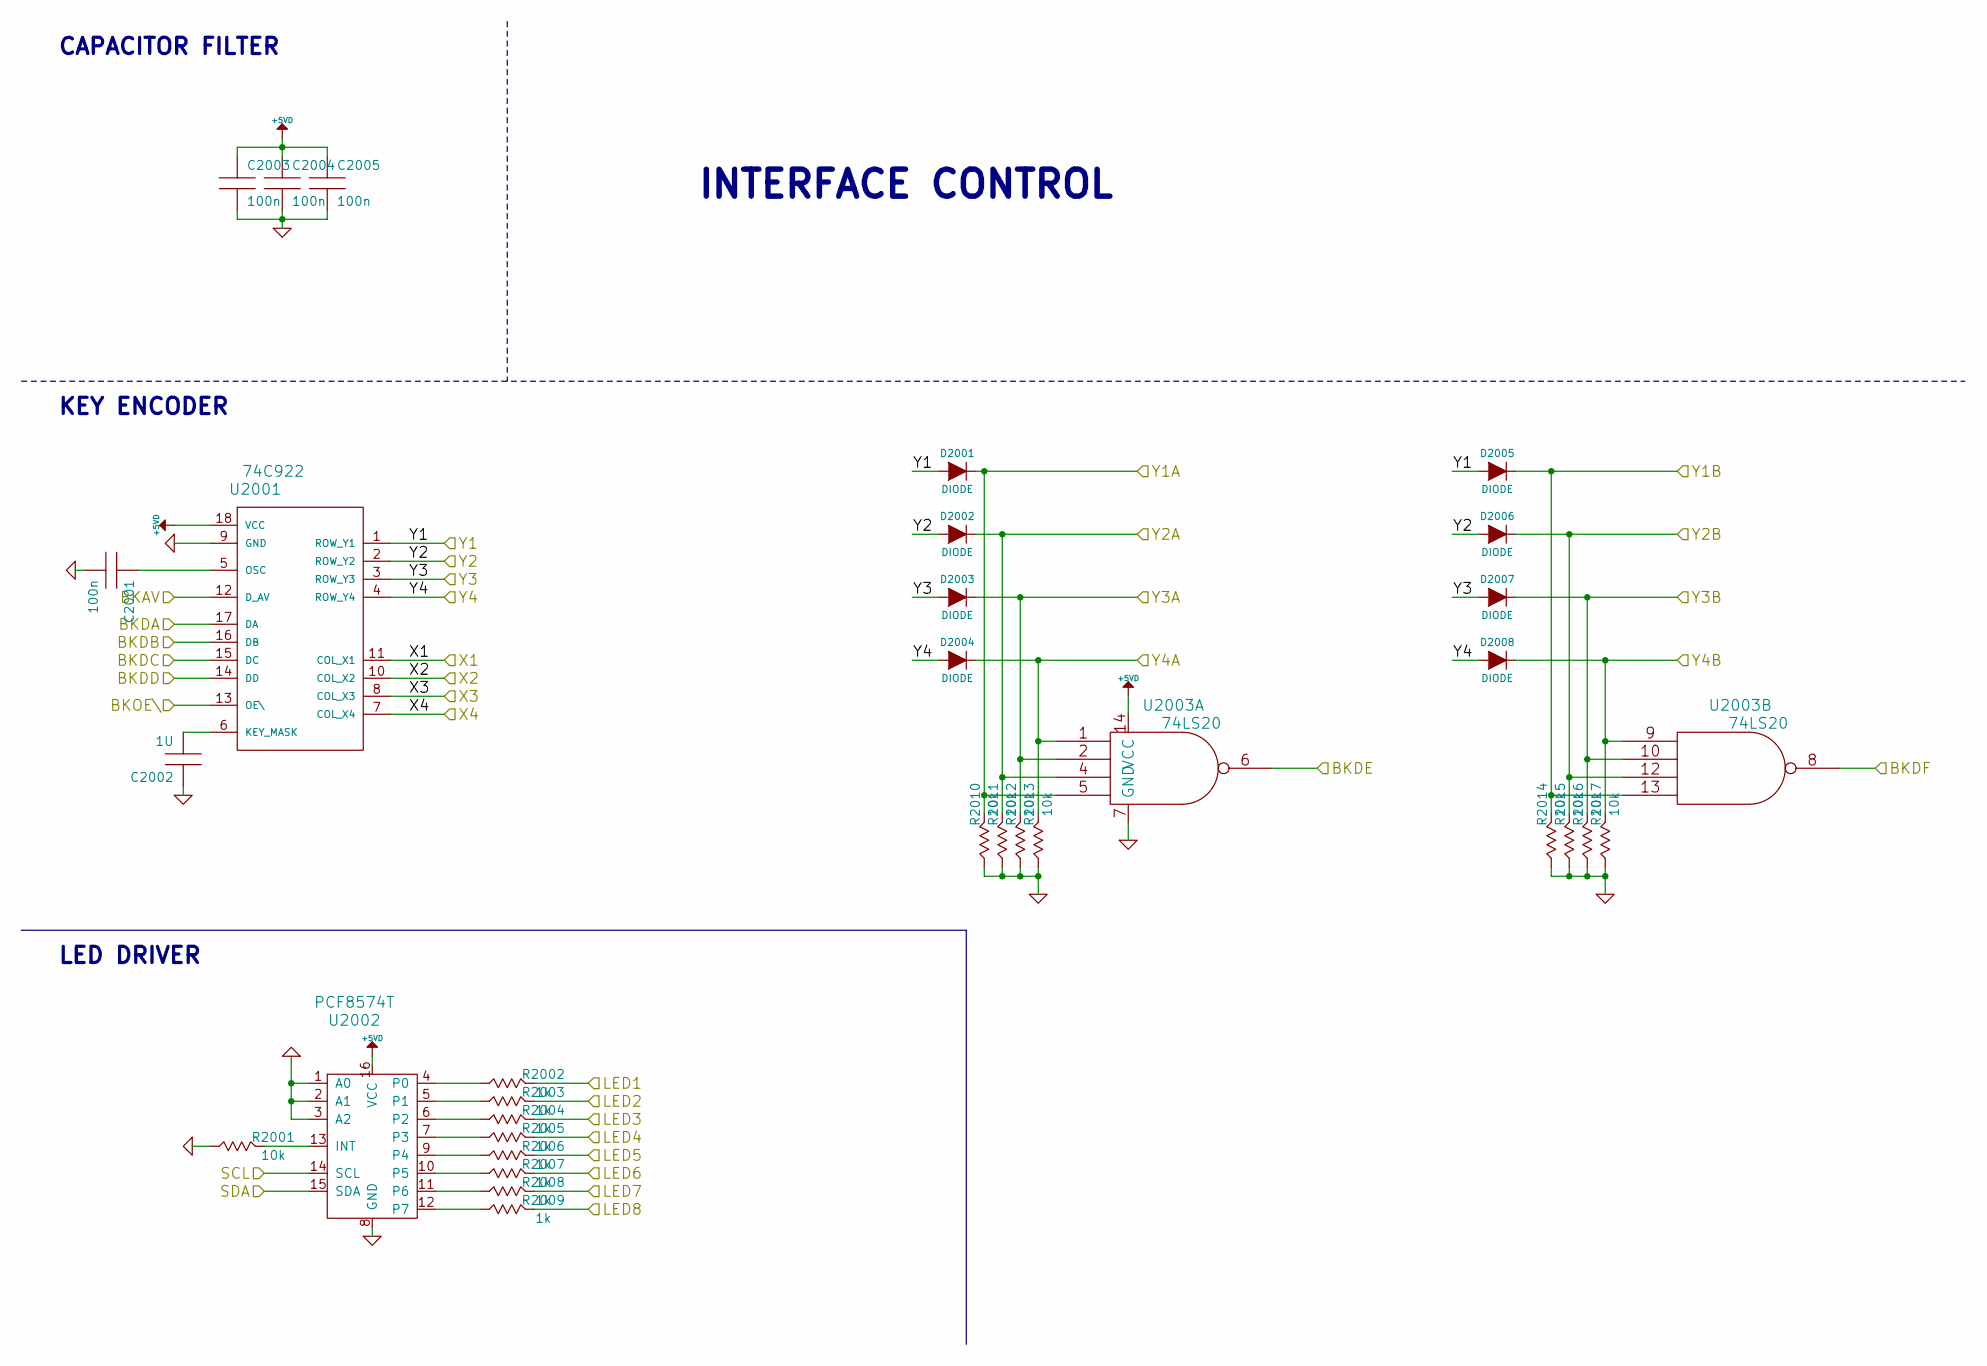
[picture p12: schematic INTERFACE BOARD.sch]

Parts:
C2001, C2003, C2004, C2005: 100n
C2002: 1U
D2001, D2002, D2003, D2004, D2005, D2006, D2007, D2008: DIODE
R2001, R2010, R2011, R2012, R2013, R2014, R2015, R2016, R2017: 10k
R2002, R2003, R2004, R2005, R2006, R2007, R2008, R2009: 1k
U2001: 74C922
U2002: PCF8574T
U2003: 74LS20

Connections:
+5VD: C2003.1, C2004.1, C2005.1, U2001.18 (VCC), U2002.16 (VCC), U2003.14 (VCC); also elsewhere on the board
/5vto3v3//BKOE: U2001.13 (OE\); also elsewhere on the board
/5vto3v3/BKAV: U2001.12 (D_AV); also elsewhere on the board
/5vto3v3/BKDA: U2001.17 (DA); also elsewhere on the board
/5vto3v3/BKDB: U2001.16 (DB); also elsewhere on the board
/5vto3v3/BKDC: U2001.15 (DC); also elsewhere on the board
/5vto3v3/BKDD: U2001.14 (DD); also elsewhere on the board
/5vto3v3/BKDE: U2003.6; also elsewhere on the board
/5vto3v3/BKDF: U2003.8; also elsewhere on the board
/INTERFACE BOARD/LED1: R2002.1; also elsewhere on the board
/INTERFACE BOARD/LED2: R2003.1; also elsewhere on the board
/INTERFACE BOARD/LED3: R2004.1; also elsewhere on the board
/INTERFACE BOARD/LED4: R2005.1; also elsewhere on the board
/INTERFACE BOARD/LED5: R2006.1; also elsewhere on the board
/INTERFACE BOARD/LED6: R2007.1; also elsewhere on the board
/INTERFACE BOARD/LED7: R2008.1; also elsewhere on the board
/INTERFACE BOARD/LED8: R2009.1; also elsewhere on the board
/INTERFACE BOARD/SCL: U2002.14 (SCL); also elsewhere on the board
/INTERFACE BOARD/SDA: U2002.15 (SDA); also elsewhere on the board
/INTERFACE BOARD/X1: U2001.11 (COL_X1); also elsewhere on the board
/INTERFACE BOARD/X2: U2001.10 (COL_X2); also elsewhere on the board
/INTERFACE BOARD/X3: U2001.8 (COL_X3); also elsewhere on the board
/INTERFACE BOARD/X4: U2001.7 (COL_X4); also elsewhere on the board
/INTERFACE BOARD/Y1: D2001.1 (A), D2005.1 (A), U2001.1 (ROW_Y1); also elsewhere on the board
/INTERFACE BOARD/Y1A: D2001.2 (K), R2010.1, U2003.5; also elsewhere on the board
/INTERFACE BOARD/Y1B: D2005.2 (K), R2014.1, U2003.13; also elsewhere on the board
/INTERFACE BOARD/Y2: D2002.1 (A), D2006.1 (A), U2001.2 (ROW_Y2); also elsewhere on the board
/INTERFACE BOARD/Y2A: D2002.2 (K), R2011.1, U2003.4; also elsewhere on the board
/INTERFACE BOARD/Y2B: D2006.2 (K), R2015.1, U2003.12; also elsewhere on the board
/INTERFACE BOARD/Y3: D2003.1 (A), D2007.1 (A), U2001.3 (ROW_Y3); also elsewhere on the board
/INTERFACE BOARD/Y3A: D2003.2 (K), R2012.1, U2003.2; also elsewhere on the board
/INTERFACE BOARD/Y3B: D2007.2 (K), R2016.1, U2003.10; also elsewhere on the board
/INTERFACE BOARD/Y4: D2004.1 (A), D2008.1 (A), U2001.4 (ROW_Y4); also elsewhere on the board
/INTERFACE BOARD/Y4A: D2004.2 (K), R2013.1, U2003.1; also elsewhere on the board
/INTERFACE BOARD/Y4B: D2008.2 (K), R2017.1, U2003.9; also elsewhere on the board
GND: C2001.2, C2002.1, C2003.2, C2004.2, C2005.2, R2001.2, R2010.2, R2011.2, R2012.2, R2013.2, R2014.2, R2015.2, R2016.2, R2017.2, U2001.9 (GND), U2002.1 (A0), U2002.2 (A1), U2002.3 (A2), U2002.8 (GND), U2003.7 (GND); also elsewhere on the board
unnamed: C2001.1, U2001.5 (OSC)
unnamed: C2002.2, U2001.6 (KEY_MASK)
unnamed: R2001.1, U2002.13 (INT)
unnamed: R2003.2, U2002.5 (P1)
unnamed: R2008.2, U2002.11 (P6)
unnamed: R2006.2, U2002.9 (P4)
unnamed: R2004.2, U2002.6 (P2)
unnamed: R2002.2, U2002.4 (P0)
unnamed: R2005.2, U2002.7 (P3)
unnamed: R2007.2, U2002.10 (P5)
unnamed: R2009.2, U2002.12 (P7)

Notes on the sheet:
CAPACITOR FILTER
KEY ENCODER
LED DRIVER
INTERFACE CONTROL
