f4deb/JK330/jk330-8-CPU/ELECTRONICAL_MAIN_BOARD_32.kicad_pcb

## KiCad design jk330-8-CPU/ELECTRONICAL_MAIN_BOARD_32.kicad_pcb (continued)

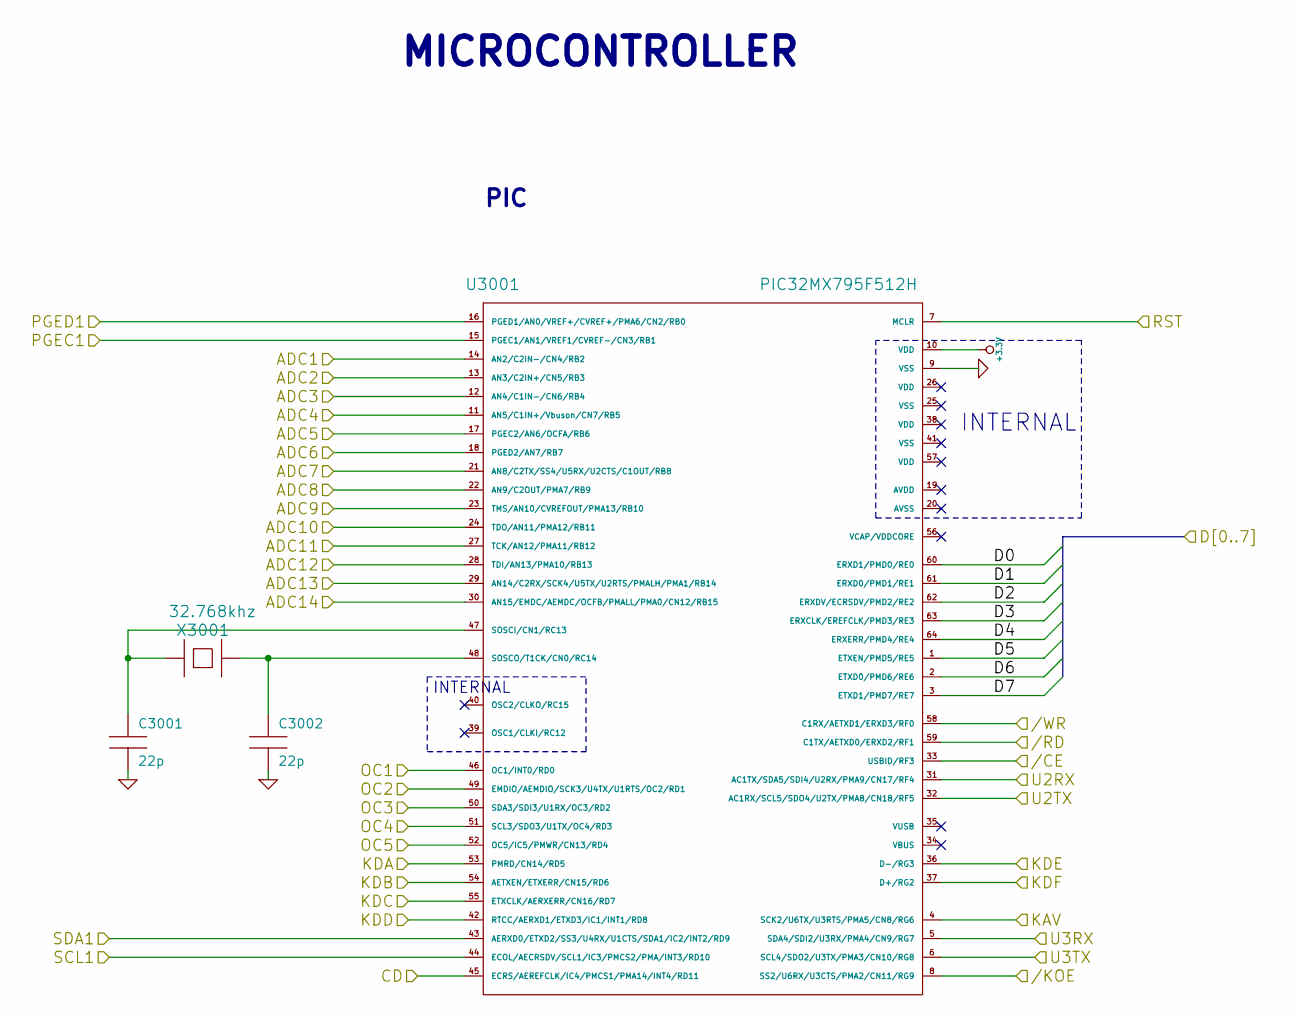
[picture p13: schematic PIC32.sch, JK330-CPU]

Parts:
C3001, C3002: 22p
U3001: PIC32MX795F512H
X3001: 32.768khz

Connections:
+3.3V: U3001.10 (VDD); also elsewhere on the board
/5vto3v3//CE: U3001.33 (USBID/RF3); also elsewhere on the board
/5vto3v3//KOE: U3001.8 (SS2/U6RX/U3CTS/PMA2/CN11/RG9); also elsewhere on the board
/5vto3v3//RD: U3001.59 (C1TX/AETXD0/ERXD2/RF1); also elsewhere on the board
/5vto3v3//WR: U3001.58 (C1RX/AETXD1/ERXD3/RF0); also elsewhere on the board
/5vto3v3/CD: U3001.45 (ECRS/AEREFCLK/IC4/PMCS1/PMA14/INT4/RD11); also elsewhere on the board
/5vto3v3/D0: U3001.60 (ERXD1/PMD0/RE0); also elsewhere on the board
/5vto3v3/D1: U3001.61 (ERXD0/PMD1/RE1); also elsewhere on the board
/5vto3v3/D2: U3001.62 (ERXDV/ECRSDV/PMD2/RE2); also elsewhere on the board
/5vto3v3/D3: U3001.63 (ERXCLK/EREFCLK/PMD3/RE3); also elsewhere on the board
/5vto3v3/D4: U3001.64 (ERXERR/PMD4/RE4); also elsewhere on the board
/5vto3v3/D5: U3001.1 (ETXEN/PMD5/RE5); also elsewhere on the board
/5vto3v3/D6: U3001.2 (ETXD0/PMD6/RE6); also elsewhere on the board
/5vto3v3/D7: U3001.3 (ETXD1/PMD7/RE7); also elsewhere on the board
/5vto3v3/KAV: U3001.4 (SCK2/U6TX/U3RTS/PMA5/CN8/RG6); also elsewhere on the board
/5vto3v3/KDA: U3001.53 (PMRD/CN14/RD5); also elsewhere on the board
/5vto3v3/KDB: U3001.54 (AETXEN/ETXERR/CN15/RD6); also elsewhere on the board
/5vto3v3/KDC: U3001.55 (ETXCLK/AERXERR/CN16/RD7); also elsewhere on the board
/5vto3v3/KDD: U3001.42 (RTCC/AERXD1/ETXD3/IC1/INT1/RD8); also elsewhere on the board
/5vto3v3/KDE: U3001.36 (D-/RG3); also elsewhere on the board
/5vto3v3/KDF: U3001.37 (D+/RG2); also elsewhere on the board
/5vto3v3/OC1: U3001.46 (OC1/INT0/RD0); also elsewhere on the board
/5vto3v3/OC2: U3001.49 (EMDIO/AEMDIO/SCK3/U4TX/U1RTS/OC2/RD1); also elsewhere on the board
/5vto3v3/OC3: U3001.50 (SDA3/SDI3/U1RX/OC3/RD2); also elsewhere on the board
/5vto3v3/OC4: U3001.51 (SCL3/SDO3/U1TX/OC4/RD3); also elsewhere on the board
/5vto3v3/OC5: U3001.52 (OC5/IC5/PMWR/CN13/RD4); also elsewhere on the board
/5vto3v3/SCL1: U3001.44 (ECOL/AECRSDV/SCL1/IC3/PMCS2/PMA/INT3/RD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); also elsewhere on the board
/5vto3v3/SDA1: U3001.43 (AERXD0/ETXD2/SS3/U4RX/U1CTS/SDA1/IC2/IN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); also elsewhere on the board
/5vto3v3/U2RX: U3001.31 (AC1TX/SDA5/SDI4/U2RX/PMA9/CN17/RF4); also elsewhere on the board
/5vto3v3/U2TX: U3001.32 (AC1RX/SCL5/SDO4/U2TX/PMA8/CN18/RF5); also elsewhere on the board
/5vto3v3/U3RX: U3001.5 (SDA4/SDI2/U3RX/PMA4/CN9/RG7); also elsewhere on the board
/5vto3v3/U3TX: U3001.6 (SCL4/SDO2/U3TX/PMA3/CN10/RG8); also elsewhere on the board
/PIC32/ADC1: U3001.14 (AN2/C2IN-/CN4/RB2); also elsewhere on the board
/PIC32/ADC2: U3001.13 (AN3/C2IN+/CN5/RB3); also elsewhere on the board
/PIC32/ADC3: U3001.12 (AN4/C1IN-/CN6/RB4); also elsewhere on the board
/PIC32/ADC4: U3001.11 (AN5/C1IN+/Vbuson/CN7/RB5); also elsewhere on the board
/PIC32/ADC5: U3001.17 (PGEC2/AN6/OCFA/RB6); also elsewhere on the board
/PIC32/ADC6: U3001.18 (PGED2/AN7/RB7); also elsewhere on the board
/PIC32/ADC7: U3001.21 (AN8/C2TX/SS4/U5RX/U2CTS/C1OUT/RB8); also elsewhere on the board
/PIC32/ADC8: U3001.22 (AN9/C2OUT/PMA7/RB9); also elsewhere on the board
/PIC32/ADC9: U3001.23 (TMS/AN10/CVREFOUT/PMA13/RB10); also elsewhere on the board
/PIC32/ADC10: U3001.24 (TDO/AN11/PMA12/RB11); also elsewhere on the board
/PIC32/ADC11: U3001.27 (TCK/AN12/PMA11/RB12); also elsewhere on the board
/PIC32/ADC12: U3001.28 (TDI/AN13/PMA10/RB13); also elsewhere on the board
/PIC32/ADC13: U3001.29 (AN14/C2RX/SCK4/U5TX/U2RTS/PMALH/PMA1/RB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); also elsewhere on the board
/PIC32/ADC14: U3001.30 (AN15/EMDC/AEMDC/OCFB/PMALL/PMA0/CN12/RB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); also elsewhere on the board
/PIC32/PGEC1: U3001.15 (PGEC1/AN1/VREF1/CVREF-/CN3/RB1); also elsewhere on the board
/PIC32/PGED1: U3001.16 (PGED1/AN0/VREF+/CVREF+/PMA6/CN2/RB0); also elsewhere on the board
/PIC32/RST: U3001.7 (MCLR); also elsewhere on the board
GND: C3001.2, C3002.2, U3001.9 (VSS); also elsewhere on the board
unnamed: C3002.1, U3001.48 (SOSCO/T1CK/CN0/RC14), X3001.2
unnamed: C3001.1, U3001.47 (SOSCI/CN1/RC13), X3001.1

Notes on the sheet:
INTERNAL
MICROCONTROLLER
PIC

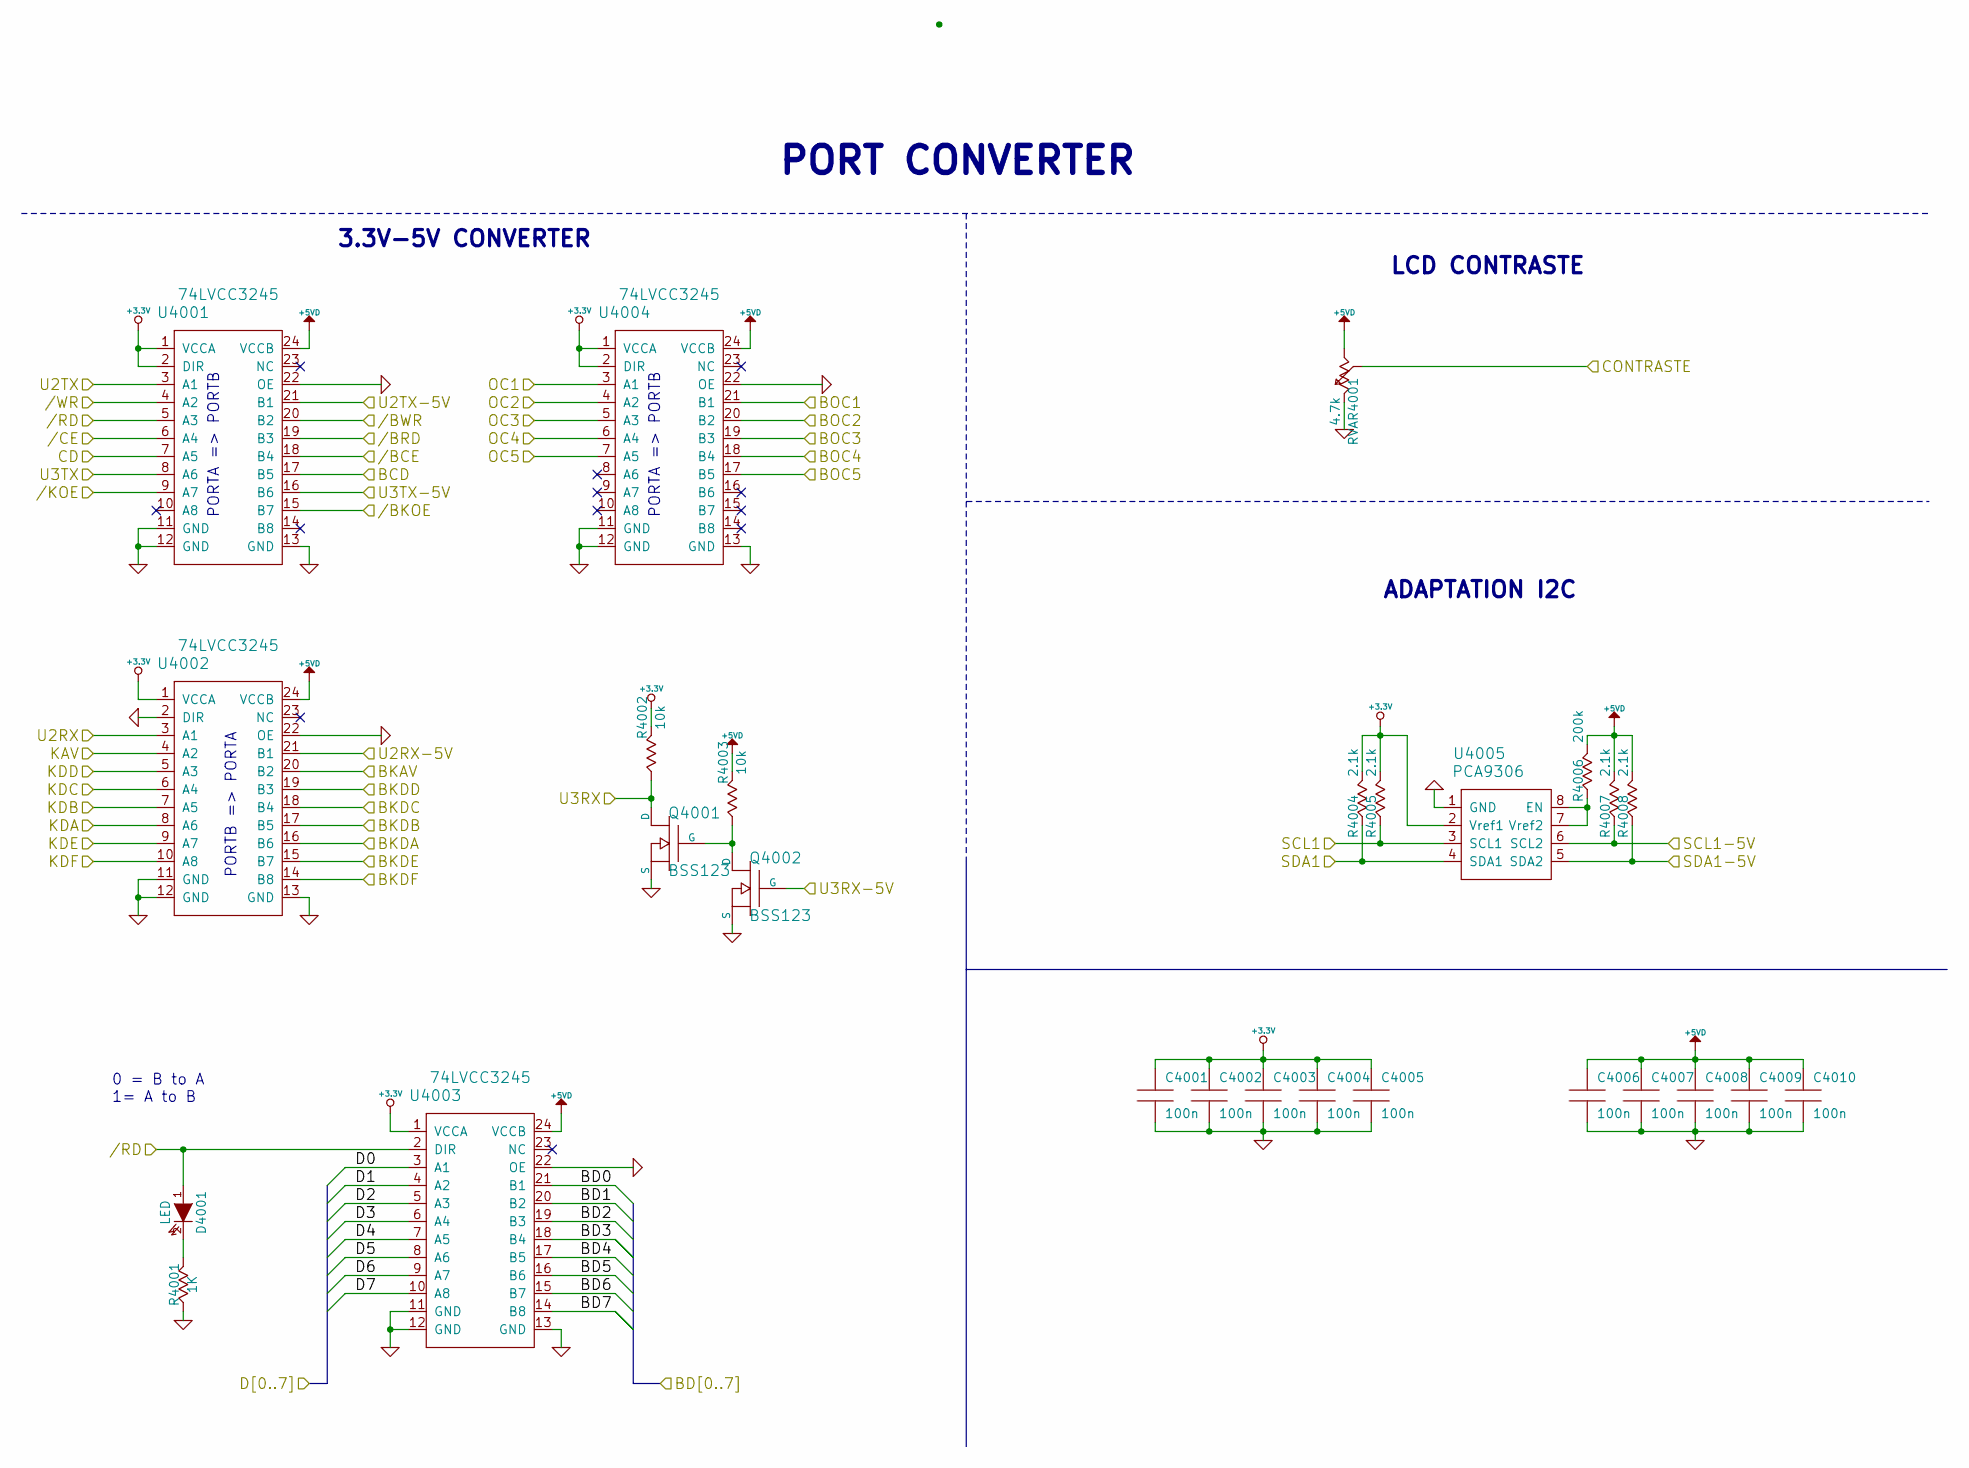
[picture p14: schematic 5vto3v3.sch, JK330-CPU]

Parts:
C4001, C4002, C4003, C4004, C4005, C4006, C4007, C4008, C4009, C4010: 100n
D4001: LED
Q4001, Q4002: BSS123
R4001: 1K
R4002, R4003: 10k
R4004, R4005, R4007, R4008: 2.1k
R4006: 200k
RVAR4001: 4.7k
U4001, U4002, U4003, U4004: 74LVCC3245
U4005: PCA9306

Connections:
+3.3V: C4001.1, C4002.1, C4003.1, C4004.1, C4005.1, R4002.1, R4004.1, R4005.1, U4001.1 (VCCA), U4001.2 (DIR), U4002.1 (VCCA), U4003.1 (VCCA), U4004.1 (VCCA), U4004.2 (DIR), U4005.2 (Vref1); also elsewhere on the board
+5VD: C4006.1, C4007.1, C4008.1, C4009.1, C4010.1, R4003.1, R4006.1, R4007.1, R4008.1, RVAR4001.2, U4001.24 (VCCB), U4002.24 (VCCB), U4003.24 (VCCB), U4004.24 (VCCB); also elsewhere on the board
/5vto3v3//BCE: U4001.18 (B4); also elsewhere on the board
/5vto3v3//BKOE: U4001.15 (B7); also elsewhere on the board
/5vto3v3//BRD: U4001.19 (B3); also elsewhere on the board
/5vto3v3//BWR: U4001.20 (B2); also elsewhere on the board
/5vto3v3//CE: U4001.6 (A4); also elsewhere on the board
/5vto3v3//KOE: U4001.9 (A7); also elsewhere on the board
/5vto3v3//RD: D4001.1 (A), U4001.5 (A3), U4003.2 (DIR); also elsewhere on the board
/5vto3v3//WR: U4001.4 (A2); also elsewhere on the board
/5vto3v3/BCD: U4001.17 (B5); also elsewhere on the board
/5vto3v3/BKAV: U4002.20 (B2); also elsewhere on the board
/5vto3v3/BKDA: U4002.16 (B6); also elsewhere on the board
/5vto3v3/BKDB: U4002.17 (B5); also elsewhere on the board
/5vto3v3/BKDC: U4002.18 (B4); also elsewhere on the board
/5vto3v3/BKDD: U4002.19 (B3); also elsewhere on the board
/5vto3v3/BKDE: U4002.15 (B7); also elsewhere on the board
/5vto3v3/BKDF: U4002.14 (B8); also elsewhere on the board
/5vto3v3/BOC1: U4004.21 (B1); also elsewhere on the board
/5vto3v3/BOC2: U4004.20 (B2); also elsewhere on the board
/5vto3v3/BOC3: U4004.19 (B3); also elsewhere on the board
/5vto3v3/BOC4: U4004.18 (B4); also elsewhere on the board
/5vto3v3/BOC5: U4004.17 (B5); also elsewhere on the board
/5vto3v3/CD: U4001.7 (A5); also elsewhere on the board
/5vto3v3/CONTRASTE: RVAR4001.3; also elsewhere on the board
/5vto3v3/D0: U4003.3 (A1); also elsewhere on the board
/5vto3v3/D1: U4003.4 (A2); also elsewhere on the board
/5vto3v3/D2: U4003.5 (A3); also elsewhere on the board
/5vto3v3/D3: U4003.6 (A4); also elsewhere on the board
/5vto3v3/D4: U4003.7 (A5); also elsewhere on the board
/5vto3v3/D5: U4003.8 (A6); also elsewhere on the board
/5vto3v3/D6: U4003.9 (A7); also elsewhere on the board
/5vto3v3/D7: U4003.10 (A8); also elsewhere on the board
/5vto3v3/KAV: U4002.4 (A2); also elsewhere on the board
/5vto3v3/KDA: U4002.8 (A6); also elsewhere on the board
/5vto3v3/KDB: U4002.7 (A5); also elsewhere on the board
/5vto3v3/KDC: U4002.6 (A4); also elsewhere on the board
/5vto3v3/KDD: U4002.5 (A3); also elsewhere on the board
/5vto3v3/KDE: U4002.9 (A7); also elsewhere on the board
/5vto3v3/KDF: U4002.10 (A8); also elsewhere on the board
/5vto3v3/OC1: U4004.3 (A1); also elsewhere on the board
/5vto3v3/OC2: U4004.4 (A2); also elsewhere on the board
/5vto3v3/OC3: U4004.5 (A3); also elsewhere on the board
/5vto3v3/OC4: U4004.6 (A4); also elsewhere on the board
/5vto3v3/OC5: U4004.7 (A5); also elsewhere on the board
/5vto3v3/SCL1: R4005.2, U4005.3 (SCL1); also elsewhere on the board
/5vto3v3/SDA1: R4004.2, U4005.4 (SDA1); also elsewhere on the board
/5vto3v3/U2RX: U4002.3 (A1); also elsewhere on the board
/5vto3v3/U2RX-5V: U4002.21 (B1); also elsewhere on the board
/5vto3v3/U2TX: U4001.3 (A1); also elsewhere on the board
/5vto3v3/U2TX-5V: U4001.21 (B1); also elsewhere on the board
/5vto3v3/U3RX: Q4001.3 (D), R4002.2; also elsewhere on the board
/5vto3v3/U3RX-5V: Q4002.2 (G); also elsewhere on the board
/5vto3v3/U3TX: U4001.8 (A6); also elsewhere on the board
/5vto3v3/U3TX-5V: U4001.16 (B6); also elsewhere on the board
/BD0: U4003.21 (B1); also elsewhere on the board
/BD1: U4003.20 (B2); also elsewhere on the board
/BD2: U4003.19 (B3); also elsewhere on the board
/BD3: U4003.18 (B4); also elsewhere on the board
/BD4: U4003.17 (B5); also elsewhere on the board
/BD5: U4003.16 (B6); also elsewhere on the board
/BD6: U4003.15 (B7); also elsewhere on the board
/BD7: U4003.14 (B8); also elsewhere on the board
/INTERFACE BOARD/SCL: R4007.2, U4005.6 (SCL2); also elsewhere on the board
/INTERFACE BOARD/SDA: R4008.2, U4005.5 (SDA2); also elsewhere on the board
GND: C4001.2, C4002.2, C4003.2, C4004.2, C4005.2, C4006.2, C4007.2, C4008.2, C4009.2, C4010.2, Q4001.1 (S), Q4002.1 (S), R4001.2, RVAR4001.1, U4001.11 (GND), U4001.12 (GND), U4001.13 (GND), U4001.22 (OE), U4002.2 (DIR), U4002.11 (GND), U4002.12 (GND), U4002.13 (GND), U4002.22 (OE), U4003.11 (GND), U4003.12 (GND), U4003.13 (GND), U4003.22 (OE), U4004.11 (GND), U4004.12 (GND), U4004.13 (GND), U4004.22 (OE), U4005.1 (GND); also elsewhere on the board
unnamed: Q4001.2 (G), Q4002.3 (D), R4003.2
unnamed: R4006.2, U4005.7 (Vref2), U4005.8 (EN)
unnamed: D4001.2 (K), R4001.1

Notes on the sheet:
ADAPTATION I2C
PORTA => PORTB
LCD CONTRASTE
0 = B to A 1= A to B
3.3V-5V CONVERTER
PORT CONVERTER
PORTB => PORTA

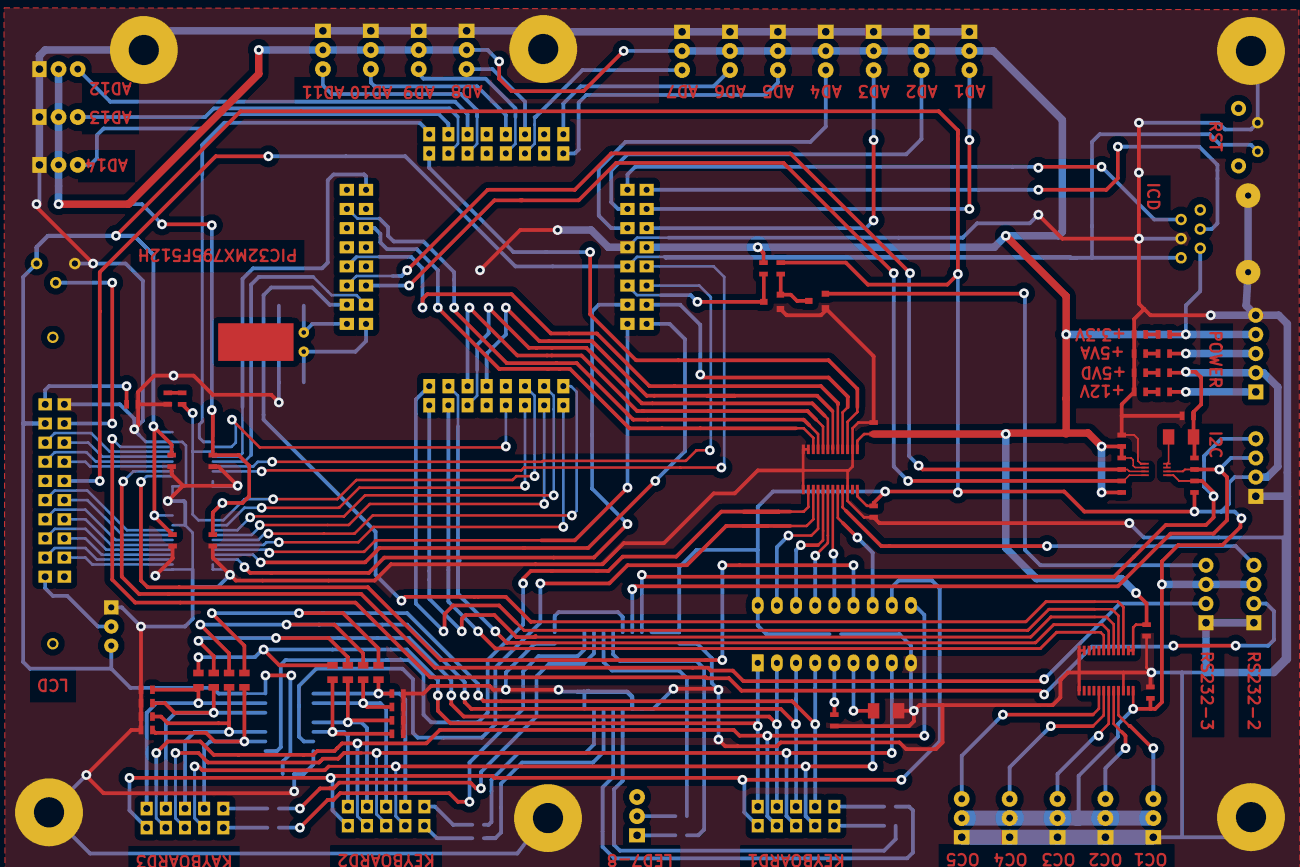
[picture p15: board ELECTRONICAL_MAIN_BOARD_32.kicad_pcb from above]

Board: 2 copper layers, 110 parts (0 on the bottom side), 131 nets.
