f4deb/JK330/SOFT/device/led/led.h

void writeBufferI2C (void);

void Led0 (BOOL state);

void Led1 (BOOL state);

void Led2 (BOOL state);

void Led3 (BOOL state);

void Led4 (BOOL state);

void Led5 (BOOL state);

void Led6 (BOOL state);

void Led7 (BOOL state);

void AllLed07 (BOOL state);

void InitLed07 (void);
