f4deb/JK330/SOFT/drivers/IO/EEPROM_I2C.h

#ifndef EEPROM_I2C_H
#define	EEPROM_I2C_H



//////////////////////////////////////////////////////
////// ATTENTION DANGER DE DESTRUCTION COMPOSANT /////
/////// ADRESSE 0xA2 et 0xA3 SONT INTERDITES /////////
//////////////////////////////////////////////////////
#define ST24C16_W 0xA4
#define ST24C16_R 0xA5
//////////////////////////////////////////////////////
//////////////////////////////////////////////////////



//  ADRESSE 0X00 reserved
void eepromI2CWrite (int adress,int EepromI2CDataWrite);

int eepromI2CRead (int adress);

#endif
