f4deb/JK330/SOFT/drivers/IO/PCF8563.h

/*
 * File:   PCF8563.h
 * Author: f4deb
 *
 * Created on 8 avril 2014, 23:56
 */

#ifndef PCF8563_H
#define	PCF8563_H

#define PCF8563_W 0xA2
#define PCF8563_R 0xA3

struct Horloge {
    int ti_hour;
    int ti_min;
    int ti_sec;
    int ti_day;
    int ti_wday;
    int ti_month;
    int ti_year;
}hor;

void getTime_8563 (void);




#endif	/* PCF8563_H */
