f4deb/JK330/SOFT/common/serial/serialOutputStream.h

#ifndef SERIAL_STREAM_H
#define SERIAL_STREAM_H

// DEFINITION DES PORTS
#define SERIAL_PORT_1           UART1
#define SERIAL_PORT_2           UART2
#define SERIAL_PORT_3           UART3
#define SERIAL_PORT_4           UART4
#define SERIAL_PORT_5           UART5
#define SERIAL_PORT_6           UART6

// D$B!)(Bfinition de la vitesse des ports series
#define BAUDERATE 115200


#endif
