f4deb/JK330/(commit log)

2013-04-28 Création du repos carteJK330-1-BF
    [Filtre Passe Bas.sch, HP.sch, JK330-1-BF.sch, MIC.sch, Mixer9Mhz.sch, NOTCH.sch, OL9Mhz.kicad_pcb, OL9Mhz.sch]
2013-04-28 correction bf996 schema
    [OL9Mhz.sch]
2013-04-29 MAJ composants
    [Filtre Passe Bas.sch, HP.sch, JK330-1-BF.sch, MIC.sch, Mixer9Mhz.sch, NOTCH.sch]
2013-04-30 Rajout commande PTT
    +12VTV
    +12VRX
    [Filtre Passe Bas.sch, HP.sch, JK330-1-BF.sch, MIC.sch, Mixer9Mhz.sch, NOTCH.sch]
2013-05-20 maj EMPREINTE
    [Filtre Passe Bas.sch, HP.sch, JK330-1-BF.sch, MIC.sch, Mixer9Mhz.sch, NOTCH.sch]
2013-06-04 MAJ mineur
    [Filtre Passe Bas.sch, HP.sch, JK330-1-BF.kicad_pcb, JK330-1-BF.sch, MIC.sch, Mixer9Mhz.sch, NOTCH.sch]
2013-06-09 Routage PCB
    [Filtre Passe Bas.sch, HP.sch, JK330-1-BF.kicad_pcb, JK330-1-BF.sch, MIC.sch, Mixer9Mhz.sch, NOTCH.sch]
2013-06-11 Reste 2 pistes a router
    [Filtre Passe Bas.sch, HP.sch, JK330-1-BF.kicad_pcb, JK330-1-BF.sch, MIC.sch, Mixer9Mhz.sch, NOTCH.sch]
2013-06-16 Fin PCB
    [Filtre Passe Bas.sch, HP.sch, JK330-1-BF.kicad_pcb, JK330-1-BF.sch, MIC.sch, Mixer9Mhz.sch, NOTCH.sch]
2013-06-18 Fin Routage PCb V0-10
    [Filtre Passe Bas.sch, HP.sch, JK330-1-BF.kicad_pcb, JK330-1-BF.sch, MIC.sch, Mixer9Mhz.sch, NOTCH.sch]
2013-07-03 LED CMS X4 12V
    [5vto3v3.sch, ELECTRONICAL_MAIN_BOARD_32.brd, ELECTRONICAL_MAIN_BOARD_32.sch, JK330-1-BF.kicad_pcb, LEDX4-12V.kicad_pcb, LEDX4-12V.sch, PIC32.sch, connector.sch]
2013-08-03 Ajout carte power
    [Filtre Passe Bas.sch, HP.sch, JK330-1-BF.kicad_pcb, JK330-1-BF.sch, JK330-9-POWER.kicad_pcb, JK330-9-POWER.sch, LEDX4-12V.kicad_pcb, LEDX4-12V.sch]
2013-08-27 MAJ mineur
    [JK330-9-POWER.kicad_pcb, JK330-9-POWER.sch]
2013-08-29 POWER PCB OK
    [JK330-9-POWER.kicad_pcb]
2013-08-29 MAJ TEXTE PCB
    [JK330-9-POWER.kicad_pcb]
2013-08-31 MAJ pour impression
    [JK330-9-POWER.kicad_pcb]
2013-08-31 MAJ EMPREINTE SELF
    [JK330-9-POWER.kicad_pcb]
2013-09-16 DEBUT CPU
    [5vto3v3.sch, ELECTRONICAL_MAIN_BOARD_32.brd, ELECTRONICAL_MAIN_BOARD_32.sch, JK330-9-POWER.sch, PIC32.sch, connector.sch]
2013-09-17 MAJ DOC TECHNIQUE
    [JK330-9-POWER.csv]
2013-09-21 MAJ CPU
    [5vto3v3.sch, ELECTRONICAL_MAIN_BOARD_32.sch, INTERFACE BOARD.sch, PIC32.sch]
2013-09-23 SCHEMA CPU 85%
    [5vto3v3.sch, ELECTRONICAL_MAIN_BOARD_32.sch, INTERFACE BOARD.sch, PIC32.sch]
2013-09-24 CPU SCHEMA 100%
    [5vto3v3.sch, ELECTRONICAL_MAIN_BOARD_32.sch, INTERFACE BOARD.sch, PIC32.sch]
2013-11-04 CPU EN TEST
    [5vto3v3.sch, CHARGEUR.sch, ELECTRONICAL_MAIN_BOARD_32.kicad_pcb, ELECTRONICAL_MAIN_BOARD_32.sch, INTERFACE BOARD.sch, PIC32.sch]
2013-11-30 LCD HD77480
    [ELECTRONICAL_MAIN_BOARD_32.kicad_pcb]
2013-12-09 DEBUT SOFT
    La base electronique est operationnel.
    [IHM.kicad_pcb, IHM.sch]
2014-02-02 MISE EN FORME
    [5vto3v3.sch, CHARGEUR.sch, ELECTRONICAL_MAIN_BOARD_32.kicad_pcb, ELECTRONICAL_MAIN_BOARD_32.sch, Filtre Passe Bas.sch, HP.sch, IHM.kicad_pcb, IHM.sch]
2014-02-02 INIT OUTPUTSTREAM UART OK
2014-05-20 TEST AJOUT PCF8573
    [PCF8573.kicad_pcb, PCF8573.sch]
2014-05-20 AJOUT CARTE PCF8574
    [PCF8574T.kicad_pcb, PCF8574T.sch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]
2014-05-20 BF BOARD UPDATE
2014-05-20 UPDATE INTERFACE SON
    [INTERFACE SON.kicad_pcb, INTERFACE SON.sch]
2014-05-20 UPDATE LED 4x
    [LEDX4-12V.kicad_pcb]
2014-05-25 MAJ MOTOR
2014-05-27 DEBUT SEQUENCE TEST MOTOR_BOARD_32
2014-06-02 AUTOTEST MOTOR BOARD READY manque IO et CAN
2014-06-14 MODIF PROG TEST MOTOR BOARD
2014-08-09 test EEPROM I2C NOK En cours
2014-08-10 ADD EEPROM_I2C rest probleme de lecture de plusieurs octets
    [EEPROM_I2C.c, EEPROM_I2C.h, MainJK330.c]
